sampidevkit/ACIM-Inverter/V0/Production/Pic/Top2.png

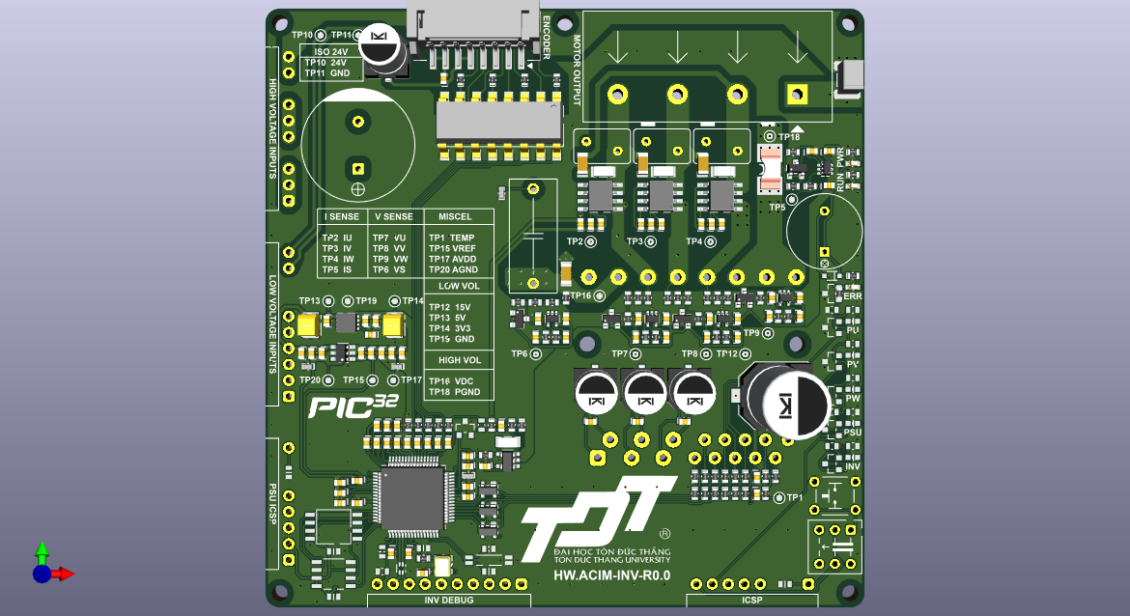
V0/Production/Pic/Top2.png
