sampidevkit/ACIM-Inverter/V0/Production/Pic/Top3.png

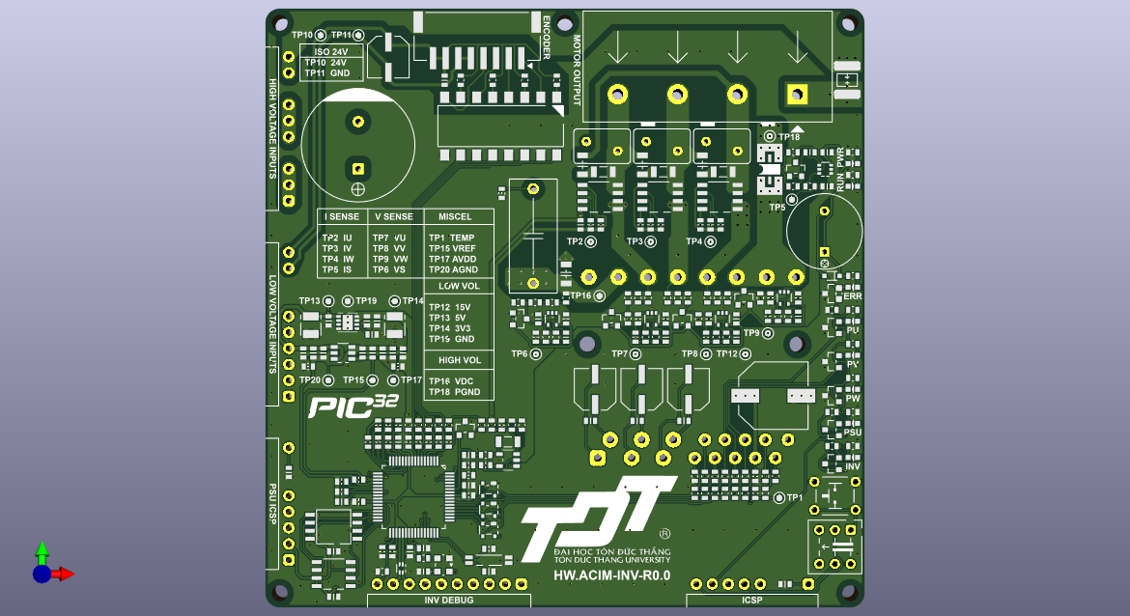
V0/Production/Pic/Top3.png
