sampidevkit/ACIM-Inverter/V0/Production/Pic/Bot.png

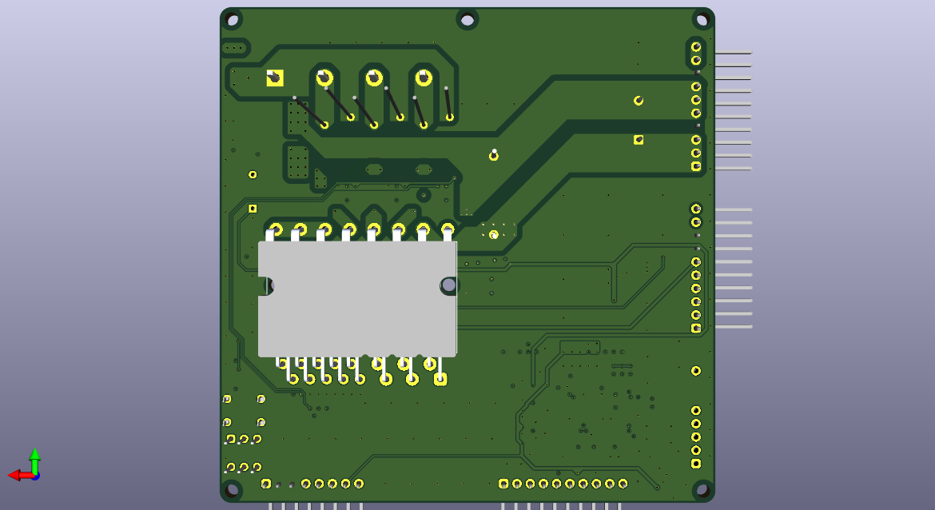
V0/Production/Pic/Bot.png
