sampidevkit/ACIM-Inverter/V0/Production/Pic/Top.png

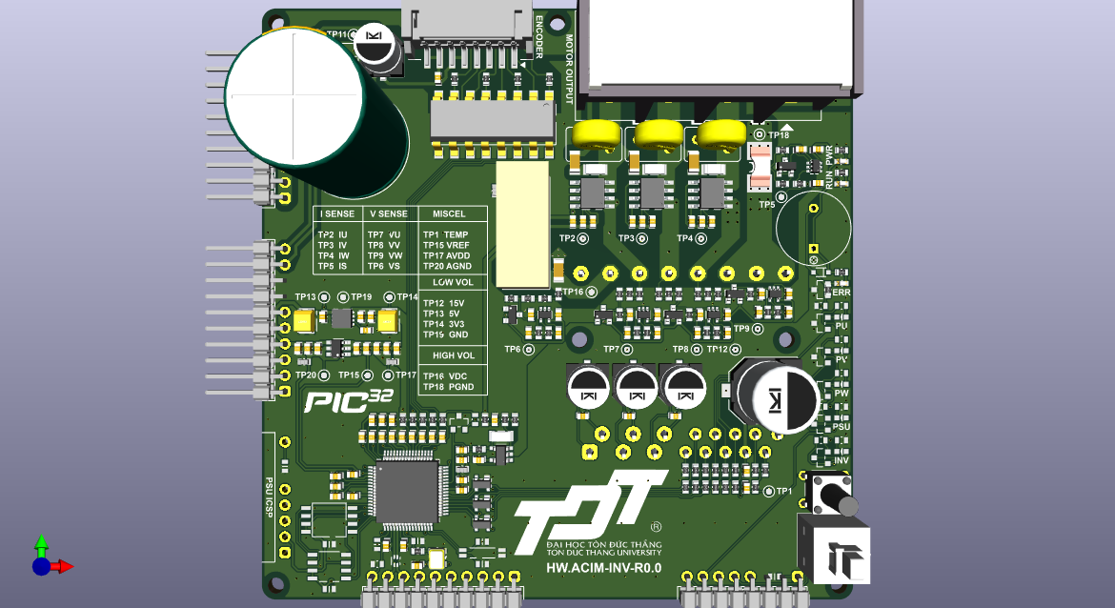
V0/Production/Pic/Top.png
