sampidevkit/ACIM-Inverter/V0/Production/BoM/HW.ACIM-INV.xlsx

# | MNP | MFT | Description | Reference | Qty | Unit Price | Sub-Price | Stock Link
1 | TS02-66-170-BK-160-SCR-D | CUI | SWITCH TACTILE 6x6x17MM SPST-NO 0.05A 12V | BT1 | 1 |  | 0
2 | AT-1224-TWT-5V-2-R | PUI | BUZZER MAGNETIC 5V 12MM TH | BZ1 | 1 |  | 0
3 | ECW-FE2W105K | Panasonic | CAP FILM 1UF 10% 450VDC RADIAL | C1 | 1 |  | 0
4 | CL10B104KB8NNNC | Samsung | CAP CER 0.1UF 50V X7R 0603 | C2,C5,C7,C9,C10,C17,C20,C22,C23,C24,C26,C27,C28,C31,C34,C35,C38,C39,C40,C41,C42,C50,C53,C61,C63,C66,C74,C78,C79,C89,C93,C94,C95,C96,C100 | 35 |  | 0
5 | A768EB476M1VLAE042 | KEMET | CAP ALUM POLY 47UF 20% 35V SMD | C3,C4,C6,C73 | 4 |  | 0
6 | CL10B102KB8NNNC | Samsung | CAP CER 1nF 50V X7R 0603 | C8,C15,C18,C19,C21,C25,C29,C30,C37,C62,C64,C65,C67,C68 | 14 |  | 0
7 | 885342208022 | WE | CAP CER 100PF 2000V X7R 1206 | C11,C12,C13,C14 | 4 |  | 0
8 | A768MS477M1ELAE017 | KEMET | CAP ALUM POLY 470UF 20% 25V SMD | C16 | 1 |  | 0
9 | TLJB227M006R0500 | KAVX | CAP TANT 220UF 20% 6.3V 1411 | C32,C83 | 2 |  | 0
10 | 0603N220J500CT | Walsin | CAP CER 22PF 50V C0G/NP0 0603 | C33,C36,C43,C44,C45,C46,C47,C49,C51,C52,C57,C58,C60,C69,C70,C71,C72,C90,C91,C97,C101 | 21 |  | 0
11 | CL10A106MQ8NNNC | Samsung | CAP CER 10UF 6.3V X5R 0603 | C48,C54,C55,C59,C92 | 5 |  | 0
12 | CL10B332KB8NNNC | Samsung | CAP CER 3.3nF 50V X7R 0603 | C56 | 1 |  | 0
13 | VW2W101MNN1825A4EF3 | Elite | CAP ALUM 100UF 20% 450V SNAP | C75 | 1 |  | 0
14 | CC0603BRNPO9BN9R0 | YAGEO | CAP CER 9PF 50V C0G/NPO 0603 | C98,C99 | 2 |  | 0
15 | MMBD4148SE | ANBON | DIODE ARRAY GP 75V 150MA SOT23 | D1,D2,D3,D4,D20 | 5 |  | 0
16 | B19Y1NB--20C000113U1930 | Harvatek | LED BLUE CLEAR 0603 SMD | D5,D14 | 2 |  | 0
17 | B1911USD-20D000114U1930 | Harvatek | LED RED DIFFUSED 0603 SMD | D6,D12 | 2 |  | 0
18 | 1N4148WX-TP | MCC | DIODE GEN PURP 75V 150MA SOD323 | D7 | 1 |  | 0
19 | B1911NG--20D000214U1930 | Harvatek | LED GREEN DIFFUSED 0603 SMD | D8 | 1 |  | 0
20 | B1931TW--20P000314U1930 | Harvatek | LED WHITE 0603 SMD | D9,D13 | 2 |  | 0
21 | PRTR5V0U2X,215 | Nexperia | TVS DIODE 5.5VWM SOT143B | D10,D11,D15 | 3 |  | 0
22 | PE-0603PFB121ST | Pulse | FERRITE BEAD 120 OHM 1A 0603 1LN | FT1,FT2,FT3,FT6 | 4 |  | 0
23 | MCM1012B121F06BPDG | INPAQ | CMF 1210 120OHM 300MA 2LN SMD | FT7 | 1 |  | 0
24 | 4532-301-LF | YAGEO | GDT SMD 4532, 300V30% 2KA, REEL | G1 | 1 |  | 0
25 | PPTC101LGBN-RC | Sullins | CONN HDR 10POS 0.1 TIN PCB R/A | J1,J4,J6 | 3 |  | 0
26 | PBC08SBAN | Sullins | CONN HEADER R/A 8POS 2.54MM | J2 | 1 |  | 0
27 | YK4410403000G | Amphenol | CONN BARRIER STRIP 4CIRC 0.374" | J3 | 1 |  | 0
28 | PPTC081LGBN-RC | Sullins | CONN HDR 8POS 0.1 TIN PCB R/A | J5 | 1 |  | 0
29 | CI0108M1HR0-NH | Cvilux | 8 POS 2.00MM(.079) SINGLE ROW SM | J8 | 1 |  | 0
30 | 561KD07 | YAGEO | VARISTOR 560V 1.75KA DISC 7MM | M1,M2,M3 | 3 |  | 0
31 | TLP293-4(TP,E | Toshiba | OPTOISOLATOR 3.75KV TRANS SO16 | OP1 | 1 |  | 0
32 | DMN2310U-7 | Diodes | MOSFET N-CH 20 V 1.6A SOT-23-3 | Q1,Q3,Q4,Q5,Q6 | 5 |  | 0
33 | SI2301CDS-T1-GE3 | Vishay | MOSFET P-CH 20V 3.1A SOT23-3 | Q2 | 1 |  | 0
34 | RC0603FR-07100KL | YAGEO | RES 100K OHM 1% 1/10W 0603 | R1,R2,R4,R8,R9,R12,R16,R17,R18,R23,R24,R25,R26,R28,R34,R35,R37,R48,R49,R51,R56,R58,R110 | 23 |  | 0
35 | AC0603FR-071K1L | YAGEO | RES SMD 1.1K OHM 1% 1/10W 0603 | R3,R6,R10,R11,R13,R14,R15,R19,R20,R21,R22,R29,R33,R36,R39,R50,R53,R55,R57,R59,R60,R62,R64,R66,R70,R71,R72 | 27 |  | 0
36 | RC0603FR-0710RL | YAGEO | RES 10 OHM 1% 1/10W 0603 | R5,R27,R32,R38,R40,R41,R42,R52 | 8 |  | 0
37 | RC0603JR-070RL | YAGEO | RES 0 OHM JUMPER 1/10W 0603 | R7,R111 | 2 |  | 0
38 | WR12X105 JTL | Walsin | RES 1M OHM 5% 1/4W 1206 | R30 | 1 |  | 0
39 | RC0603FR-13470KL | YAGEO | RES 470K OHM 1% 1/10W 0603 | R31 | 1 |  | 0
40 | MSMA2512R0050FGM | Eaton | RES 0.005 OHM 1% 3W 2512 | R43 | 1 |  | 0
41 | AC0603FR-074K3L | YAGEO | RES SMD 4.3K OHM 1% 1/10W 0603 | R44,R45,R46,R61 | 4 |  | 0
42 | RC0603FR-0710KL | YAGEO | RES 10K OHM 1% 1/10W 0603 | R47,R54 | 2 |  | 0
43 | RNCP1206FTD4R70 | Stackpole | RES 4.7 OHM 1% 1/2W 1206 | R63,R68,R69 | 3 |  | 0
44 | TL2201EEYA | E-Switch | SWITCH PUSH DPDT 0.1A 30V | SW1 | 1 |  | 0
45 | IKCM15H60GAXKMA2 | Infineon | IFPS MODULES 24MDIP | U1 | 1 |  | 0
46 | NCV21871SQ3T2G | Onsemi | IC OPAMP GP 1 CIRCUIT SC88A | U2,U12,U15,U16 | 4 |  | 0
47 | ZXCT199QA1DW-7 | Diodes | CM VOLTAGE OUTPUT SOT363 T&R 3K | U3 | 1 |  | 0
48 | AP331AWG-7 | Diodes | IC COMPARATOR 1 GEN PUR SOT25 | U4 | 1 |  | 0
49 | PIC32MK1024MCM064-I/PT | Microchip | IC MCU 32BIT 1MB FLASH 64TQFP | U5 | 1 |  | 0
50 | DSC1001CE1-012.0000 | Microchip | MEMS OSC XO 12.0000MHZ CMOS SMD | U6 | 1 |  | 0
51 | ACS724LLCTR-10AB-T | Allegro | SENSOR CURRENT HALL 10A AC/DC | U7,U9,U10 | 3 |  | 0
52 | MCP1501T-33E/CHY | Microchip | IC VREF SERIES 0.1% SOT23-6 | U8 | 1 |  | 0
53 | M95256-WMN6P | ST | IC EEPROM 256KBIT SPI 8SOIC | U11 | 1 |  | 0
54 | W25Q128FVSG | Winbond | IC FLASH 128MBIT SPI/QUAD 8SOIC | U13 | 1 |  | 0
55 | MCP1727-3302E/MF | Microchip | IC REG LINEAR 3.3V 1.5A 8DFN | U14 | 1 |  | 0
56 | 32.768K12.5PI/6914E | YIC | CRYSTAL 32.7680KHZ 12.5PF SMD | X1 | 1 |  | 0
 |  |  |  |  |  |  | 0
