sampidevkit/ACIM-Inverter/V0/Production/Sch/HW.ACIM-INV.pdf

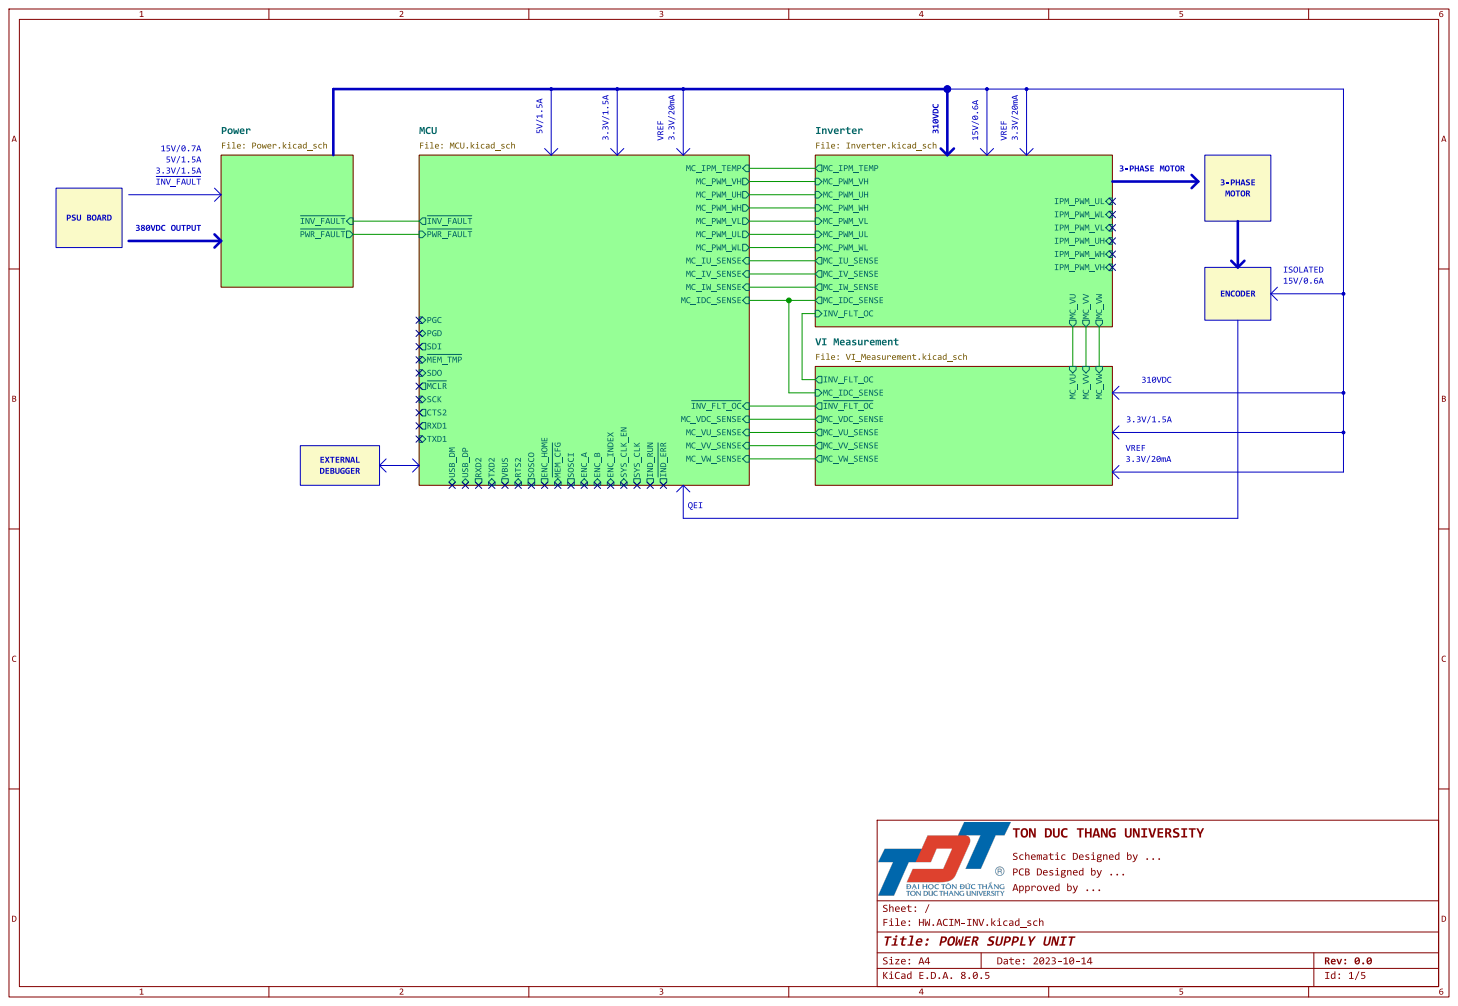
[picture p5: page 1]

Schematic Designed by ... PCB Designed by ... Approved by ...

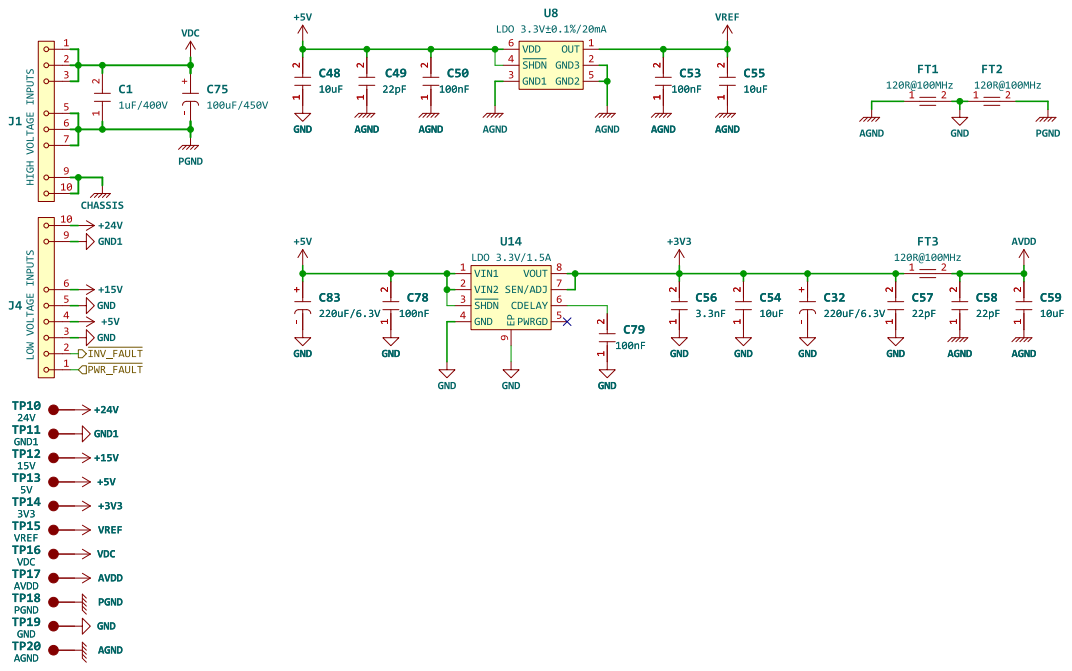
[picture p6: page 2]

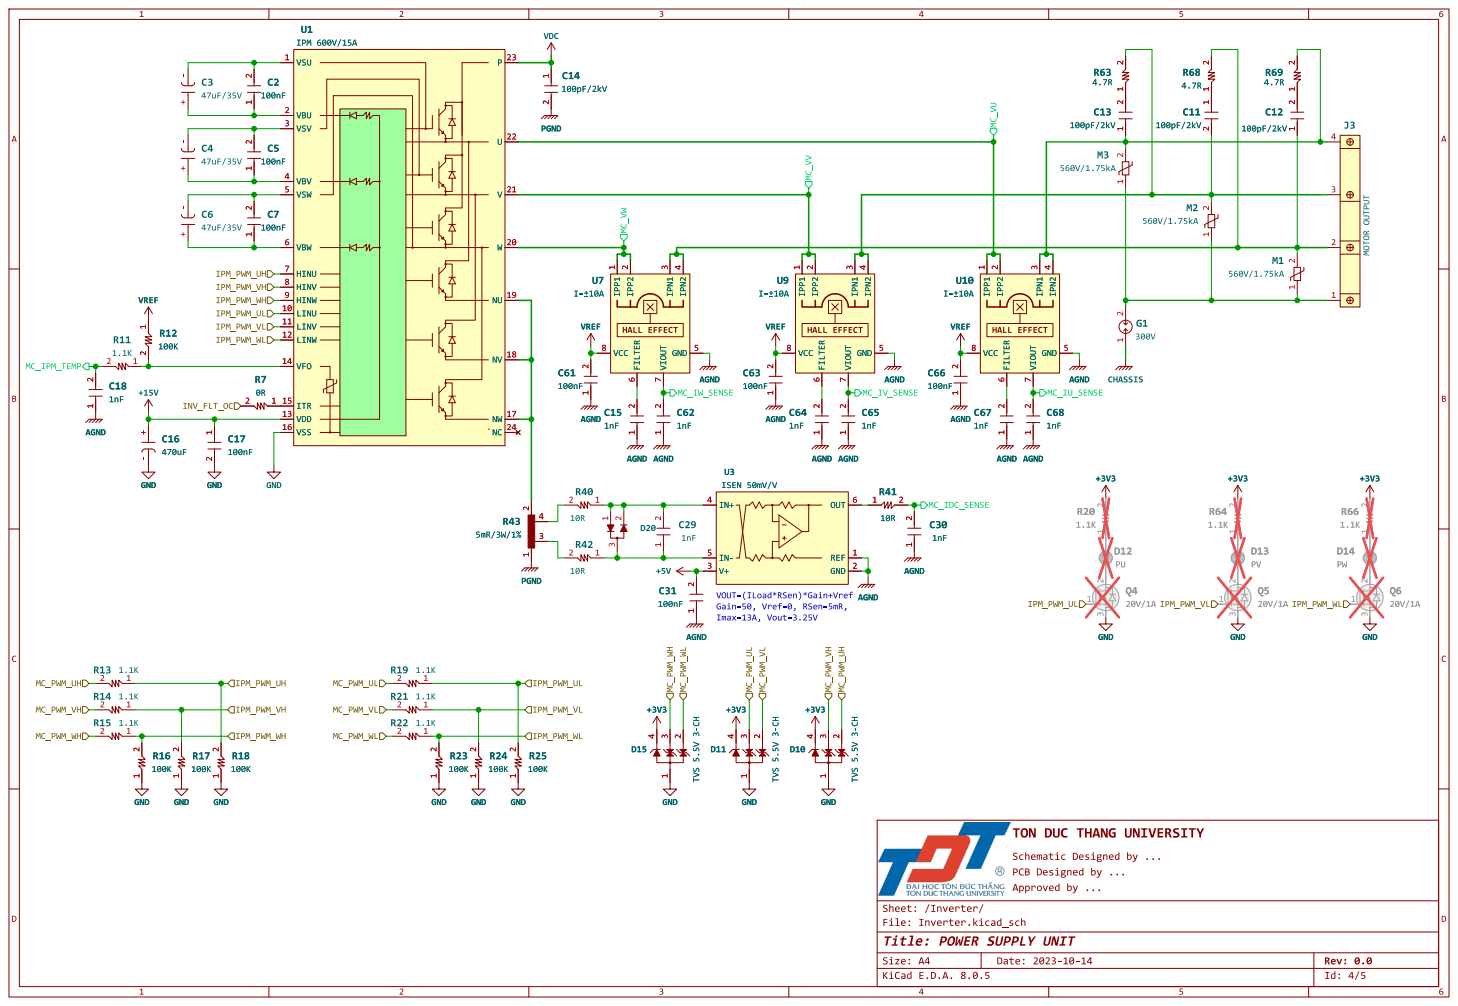
[picture p7: page 3]

Schematic Designed by ... PCB Designed by ... Approved by ...

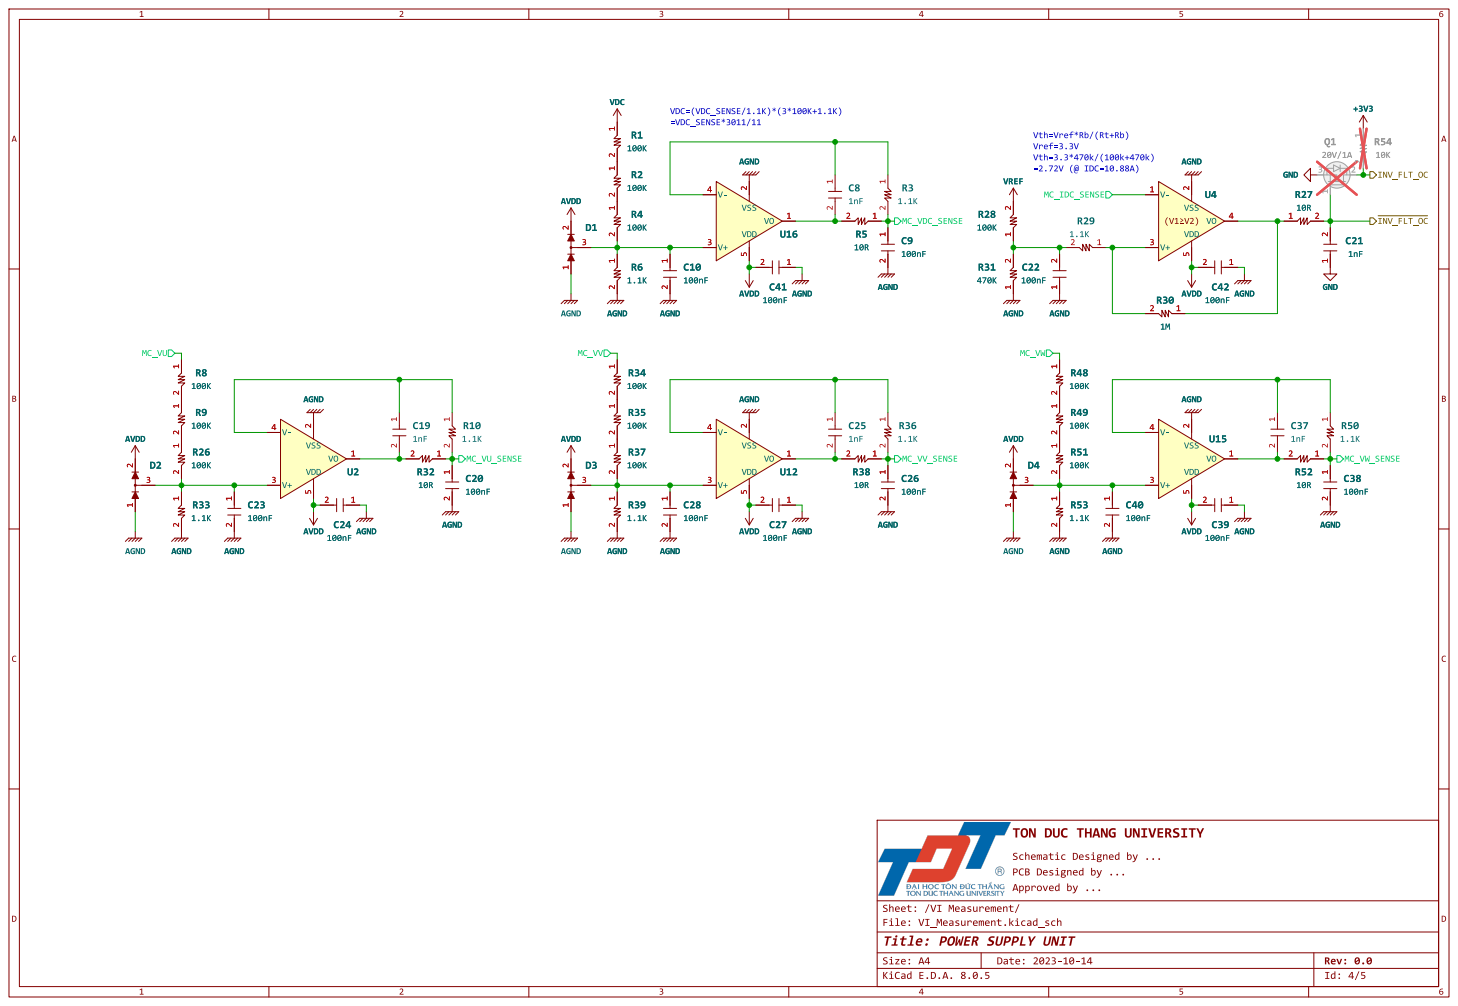
[picture p8: page 4]

Schematic Designed by ... PCB Designed by ... Approved by ...

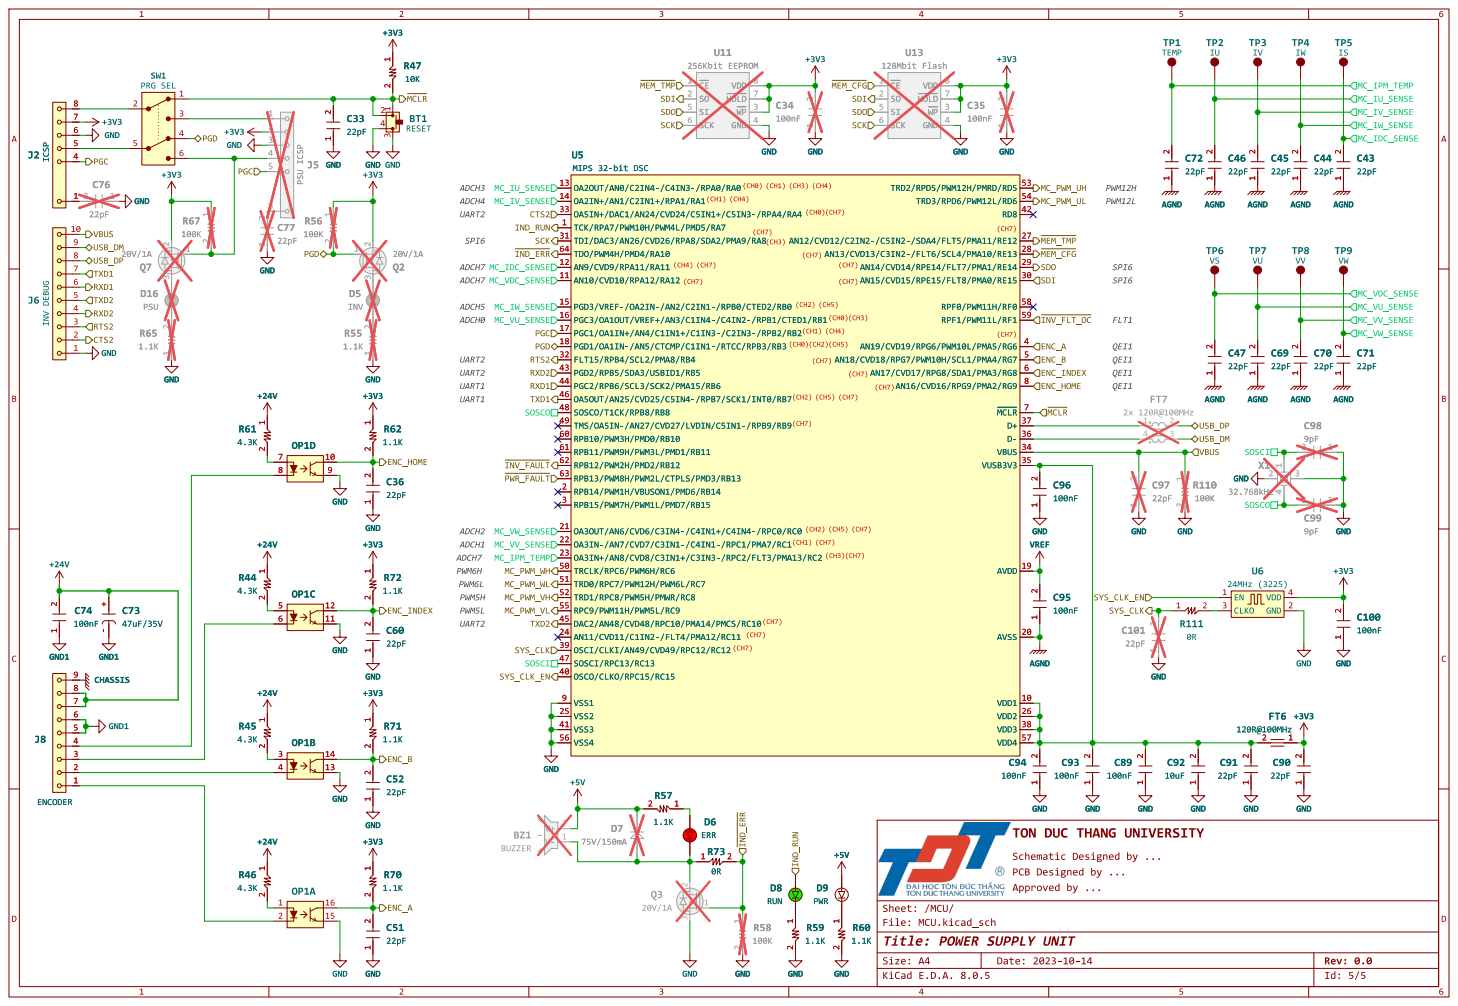
[picture p9: page 5]

1 2 GND
Schematic Designed by ... PCB Designed by ... Approved by ... 1 2 R46
