sampidevkit/ACIM-Inverter/V0/Design/HW.ACIM-INV/Inverter.kicad_sch

## KiCad design V0/Design/HW.ACIM-INV/Inverter.kicad_sch (2024-09-25)

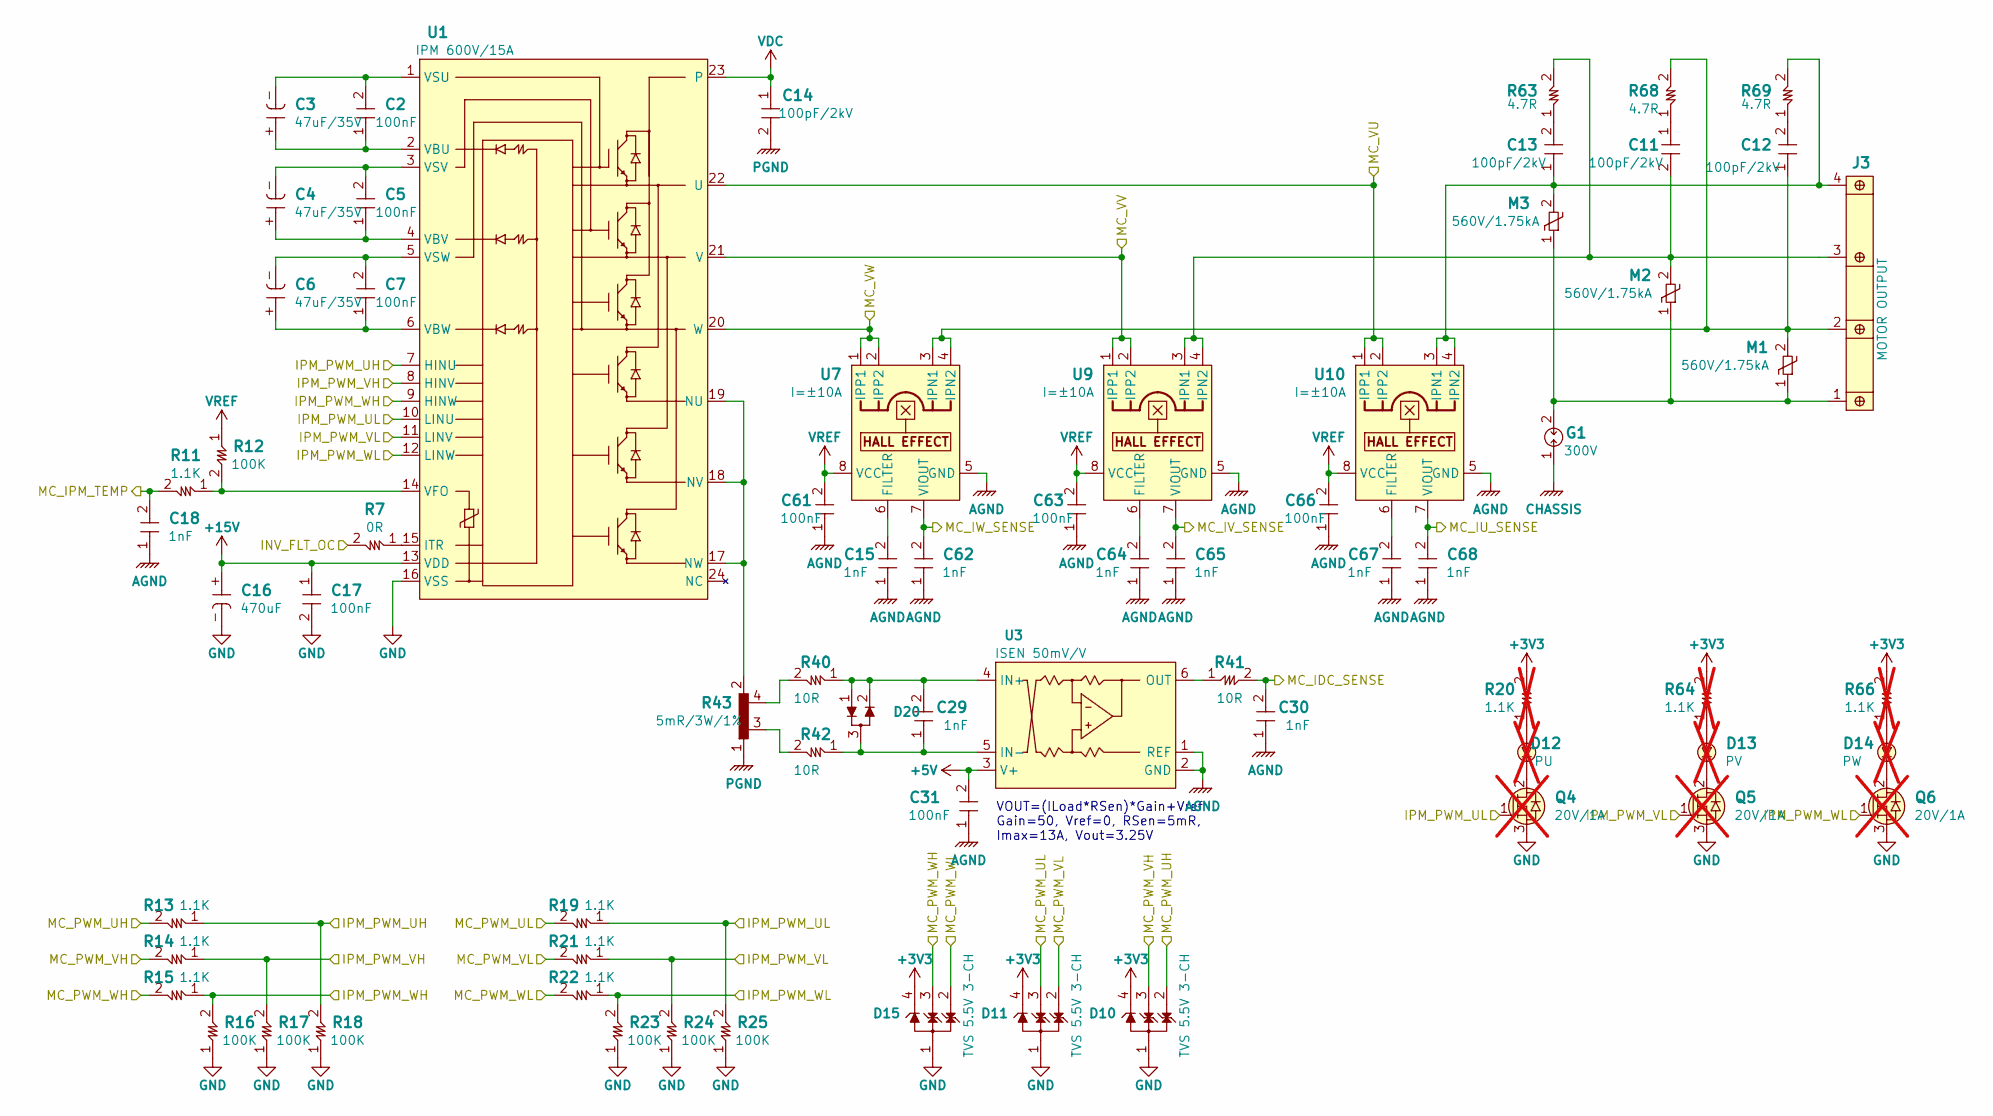
[picture p10: schematic Inverter.kicad_sch]

Parts:
C2, C5, C7, C17, C31, C61, C63, C66: 100nF; CAP0603
C3, C4, C6: 47uF/35V; CAP_ELEC-6.6x6.6-DIA6.3
C11, C12, C13, C14: 100pF/2kV; CAP1206
C15, C18, C29, C30, C62, C64, C65, C67, C68: 1nF; CAP0603
C16: 470uF; CAP_ELEC-10.3x10.3-DIA10
D10, D11, D15: TVS 5.5V 3-CH; SOT143B_NEXT
D12: PU; LED0603; not fitted
D13: PV; LED0603; not fitted
D14: PW; LED0603; not fitted
D20: GP DIODE; SOT23
G1: 300V; GDT1812_3532
J3: MOTOR OUTPUT; TMB4_9.5
M1, M2, M3: 560V/1.75kA; MOV5MM
Q4, Q5, Q6: 20V/1A; SOT23; not fitted
R7: 0R; RES0603
R11, R13, R14, R15, R19, R21, R22: 1.1K; RES0603
R12, R16, R17, R18, R23, R24, R25: 100K; RES0603
R20, R64, R66: 1.1K; RES0603; not fitted
R40, R41, R42: 10R; RES0603
R43: 5mR/3W/1%; SHU2512
R63, R68, R69: 4.7R; RES1206
U1: IPM 600V/15A; CIPOS-MINI
U3: ISEN 50mV/V; SOT363
U7, U9, U10: I=±10A; SOIC8_ALL

Connections:
+3V3: D10.4 (CH3), D11.4 (CH3), D15.4 (CH3), R20.2, R64.2, R66.2
+5V: C31.2, U3.3 (V+)
+15V: C16.+, C17.1, U1.13 (VDD)
AGND: C15.1, C18.1, C30.1, C31.1, C61.1, C62.1, C63.1, C64.1, C65.1, C66.1, C67.1, C68.1, U3.1 (REF), U3.2 (GND), U7.5 (GND), U9.5 (GND), U10.5 (GND)
CHASSIS: G1.1
GND: C16.-, C17.2, D10.1 (GND), D11.1 (GND), D15.1 (GND), Q4.3 (S), Q5.3 (S), Q6.3 (S), R16.1, R17.1, R18.1, R23.1, R24.1, R25.1, U1.16 (VSS)
INV_FLT_OC: R7.2
IPM_PWM_UH: R13.1, R18.2, U1.7 (HINU)
IPM_PWM_UL: Q4.1 (G), R19.1, R25.2, U1.10 (LINU)
IPM_PWM_VH: R14.1, R17.2, U1.8 (HINV)
IPM_PWM_VL: Q5.1 (G), R21.1, R24.2, U1.11 (LINV)
IPM_PWM_WH: R15.1, R16.2, U1.9 (HINW)
IPM_PWM_WL: Q6.1 (G), R22.1, R23.2, U1.12 (LINW)
MC_IDC_SENSE: C30.2, R41.2
MC_IPM_TEMP: C18.2, R11.2
MC_IU_SENSE: C68.2, U10.7 (VIOUT)
MC_IV_SENSE: C65.2, U9.7 (VIOUT)
MC_IW_SENSE: C62.2, U7.7 (VIOUT)
MC_PWM_UH: D10.2 (CH1), R13.2
MC_PWM_UL: D11.3 (CH2), R19.2
MC_PWM_VH: D10.3 (CH2), R14.2
MC_PWM_VL: D11.2 (CH1), R21.2
MC_PWM_WH: D15.3 (CH2), R15.2
MC_PWM_WL: D15.2 (CH1), R22.2
MC_VU: U1.22 (U), U10.1 (IPP1), U10.2 (IPP2)
MC_VV: U1.21 (V), U9.1 (IPP1), U9.2 (IPP2)
MC_VW: U1.20 (W), U7.1 (IPP1), U7.2 (IPP2)
unnamed: C2.1, C3.+, U1.2 (VBU)
unnamed: C2.2, C3.-, U1.1 (VSU)
unnamed: C4.+, C5.1, U1.4 (VBV)
unnamed: C4.-, C5.2, U1.3 (VSV)
unnamed: C6.+, C7.1, U1.6 (VBW)
unnamed: C6.-, C7.2, U1.5 (VSW)
unnamed: C11.1, R68.1
unnamed: C11.2, J3.3, M2.2, R63.2, U9.3 (IPN1), U9.4 (IPN2)
unnamed: C12.1, J3.2, M1.2, R68.2, U7.3 (IPN1), U7.4 (IPN2)
unnamed: C12.2, R69.1
unnamed: C13.1, J3.4, M3.2, R69.2, U10.3 (IPN1), U10.4 (IPN2)
unnamed: C13.2, R63.1
unnamed: C15.2, U7.6 (FILTER)
unnamed: C29.1, D20.3 (COM), R42.1, U3.5 (IN-)
unnamed: C29.2, D20.1 (K1), D20.2 (K2), R40.1, U3.4 (IN+)
unnamed: C64.2, U9.6 (FILTER)
unnamed: C67.2, U10.6 (FILTER)
unnamed: D12.A, R20.1
unnamed: D12.K, Q4.2 (D)
unnamed: D13.A, R64.1
unnamed: D13.K, Q5.2 (D)
unnamed: D14.A, R66.1
unnamed: D14.K, Q6.2 (D)
unnamed: G1.2, J3.1, M1.1, M2.1, M3.1
unnamed: R7.1, U1.15 (ITR)
unnamed: R11.1, R12.2, U1.14 (VFO)
unnamed: R40.2, R43.4
unnamed: R41.1, U3.6 (OUT)
unnamed: R42.2, R43.3
unnamed: R43.2, U1.17 (NW), U1.18 (NV), U1.19 (NU)
PGND: C14.2, R43.1
VDC: C14.1, U1.23
VREF: C61.2, C63.2, C66.2, R12.1, U7.8 (VCC), U9.8 (VCC), U10.8 (VCC)

Notes on the sheet:
VOUT=(ILoad*RSen)*Gain+Vref Gain=50, Vref=0, RSen=5mR, Imax=13A, Vout=3.25V
