sampidevkit/ACIM-Inverter/V0/Design/HW.ACIM-INV/MCU.kicad_sch

## KiCad design V0/Design/HW.ACIM-INV/MCU.kicad_sch (2024-10-11)

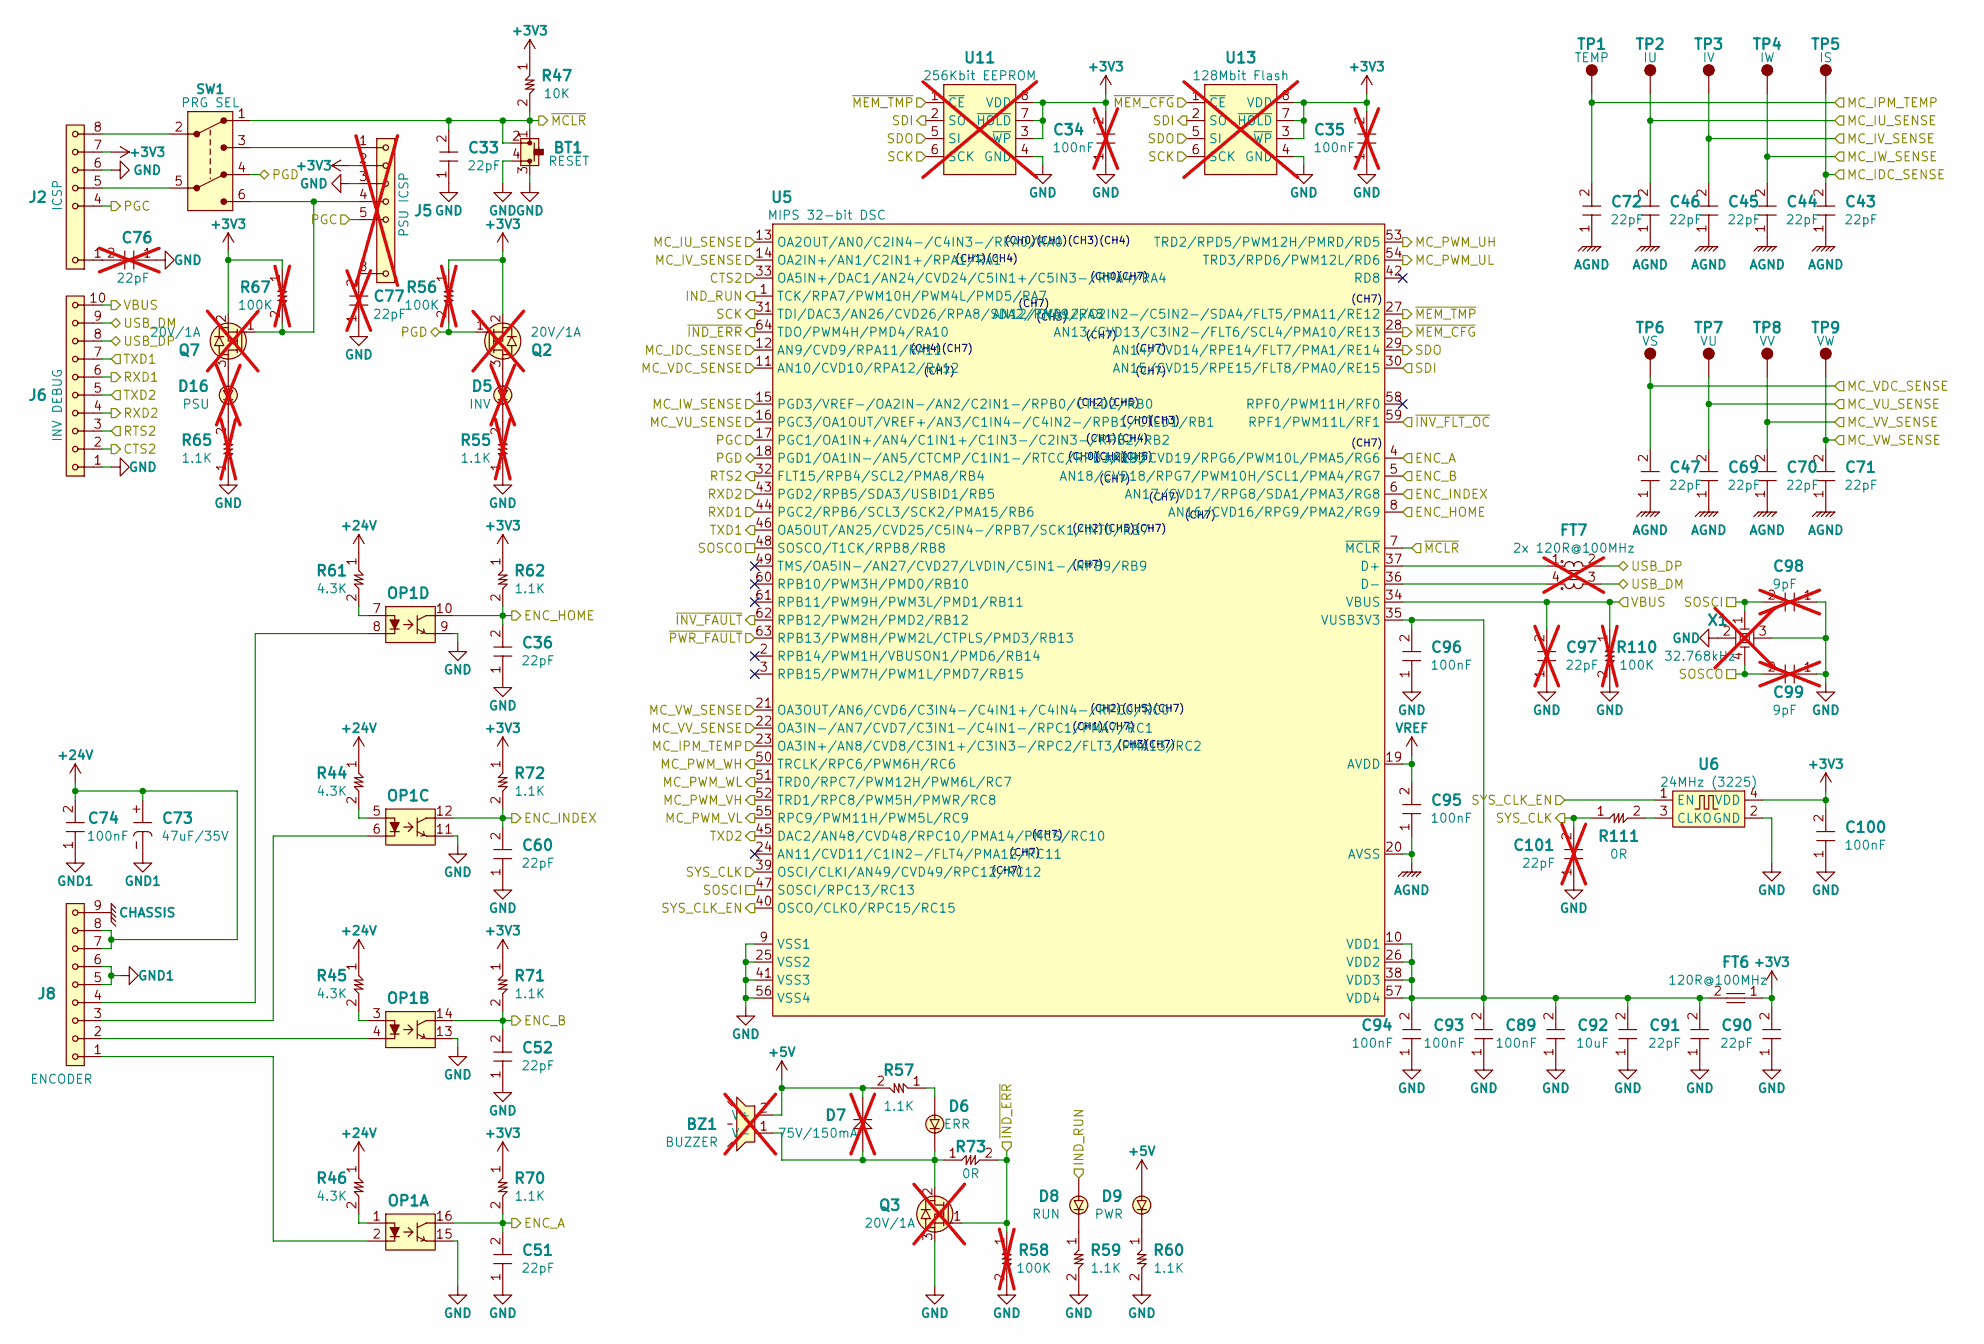
[picture p11: schematic MCU.kicad_sch]

Parts:
BT1: RESET; BUTTON_4P_6x6
BZ1: BUZZER; AT-1224; not fitted
C33, C36, C43, C44, C45, C46, C47, C51, C52, C60, C69, C70, C71, C72, C90, C91: 22pF; CAP0603
C34, C35: 100nF; CAP0603; not fitted
C73: 47uF/35V; CAP_ELEC-6.6x6.6-DIA6.3
C74, C89, C93, C94, C95, C96, C100: 100nF; CAP0603
C76, C77, C97, C101: 22pF; CAP0603; not fitted
C92: 10uF; CAP0603
C98, C99: 9pF; CAP0603; not fitted
D5: INV; LED0603; not fitted
D6: ERR; LED0603
D7: 75V/150mA; SOD-323; not fitted
D8: RUN; LED0603
D9: PWR; LED0603
D16: PSU; LED0603; not fitted
FT6: 120R@100MHz; FT0603
FT7: 2x 120R@100MHz; IND1210_4P; not fitted
J2: ICSP; HDM1x8x2.54_TH_RA
J5: PSU ICSP; HDF1x8x2.54_TH_RA; not fitted
J6: INV DEBUG; HDM1x10x2.54_TH_RA
J8: ENCODER; HDM1x8x2.0_SMA_RA
OP1: OPTO-BJT-4CH; OPTO_SO16_6.5MM
Q2, Q3, Q7: 20V/1A; SOT23; not fitted
R44, R45, R46, R61: 4.3K; RES0603
R47: 10K; RES0603
R55, R65: 1.1K; RES0603; not fitted
R56, R58, R67, R110: 100K; RES0603; not fitted
R57, R59, R60, R62, R70, R71, R72: 1.1K; RES0603
R73, R111: 0R; RES0603
SW1: PRG SEL; SW_PUSH_2DPDT
TP1: TEMP; TP1MM
TP2: IU; TP1MM
TP3: IV; TP1MM
TP4: IW; TP1MM
TP5: IS; TP1MM
TP6: VS; TP1MM
TP7: VU; TP1MM
TP8: VV; TP1MM
TP9: VW; TP1MM
U5: MIPS 32-bit DSC; TQFP64_10x10_MCHP
U6: 24MHz (3225); CDFN3225-4LD-PL-1
U11: 256Kbit EEPROM; SOIC8_3.9_MCHP; not fitted
U13: 128Mbit Flash; SO8W_5.3; not fitted
X1: 32.768kHz; SMD4-7015; not fitted

Connections:
+3V3: C34.2, C35.2, C90.2, C100.2, FT6.1, J2.7, J5.2, Q2.2 (S), Q7.2 (S), R47.1, R56.1, R62.1, R67.1, R70.1, R71.1, R72.1, U6.4 (VDD), U11.3 (~WP), U11.7 (~HOLD), U11.8 (VDD), U13.3 (~WP), U13.7 (~HOLD), U13.8 (VDD)
+5V: BZ1.2 (V+), D7.K, D9.A, R57.2
+24V: C73.+, C74.2, J8.7, J8.8, R44.1, R45.1, R46.1, R61.1
AGND: C43.1, C44.1, C45.1, C46.1, C47.1, C69.1, C70.1, C71.1, C72.1, C95.1, U5.20 (AVSS)
CHASSIS: J8.9
CTS2: J6.2, U5.33 (OA5IN+/DAC1/AN24/CVD24/C5IN1+/C5IN3-/RP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)
ENC_A: C51.2, OP1.16 (C1), R70.2, U5.4 (AN19/CVD19/RPG6/PWM10L/PMA5/RG6)
ENC_B: C52.2, OP1.14 (C2), R71.2, U5.5 (AN18/CVD18/RPG7/PWM10H/SCL1/PMA4/RG7)
ENC_HOME: C36.2, OP1.10 (C4), R62.2, U5.8 (AN16/CVD16/RPG9/PMA2/RG9)
ENC_INDEX: C60.2, OP1.12 (C3), R72.2, U5.6 (AN17/CVD17/RPG8/SDA1/PMA3/RG8)
GND: BT1.3, BT1.4, C33.1, C34.1, C35.1, C36.1, C51.1, C52.1, C60.1, C76.1, C77.1, C89.1, C90.1, C91.1, C92.1, C93.1, C94.1, C96.1, C97.1, C98.1, C99.1, C100.1, C101.1, J2.6, J5.3, J6.1, OP1.9 (E4), OP1.11 (E3), OP1.13 (E2), OP1.15 (E1), Q3.3 (S), R55.1, R58.2, R59.2, R60.2, R65.1, R110.2, U5.9 (VSS1), U5.25 (VSS2), U5.41 (VSS3), U5.56 (VSS4), U6.2 (GND), U11.4 (GND), U13.4 (GND), X1.2 (GND1), X1.3 (X2)
GND1: C73.-, C74.1, J8.5, J8.6
IND_RUN: D8.A, U5.1 (TCK/RPA7/PWM10H/PWM4L/PMD5/RA7)
MC_IDC_SENSE: C43.2, TP5.1, U5.12 (AN9/CVD9/RPA11/RA11)
MC_IPM_TEMP: C72.2, TP1.1, U5.23 (OA3IN+/AN8/CVD8/C3IN1+/C3IN3-/RPC2/FLT3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)
MC_IU_SENSE: C46.2, TP2.1, U5.13 (OA2OUT/AN0/C2IN4-/C4IN3-/RPA0/RA0)
MC_IV_SENSE: C45.2, TP3.1, U5.14 (OA2IN+/AN1/C2IN1+/RPA1/RA1)
MC_IW_SENSE: C44.2, TP4.1, U5.15 (PGD3/VREF-/OA2IN-/AN2/C2IN1-/RPB0/CTED2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)
MC_PWM_UH: U5.53 (TRD2/RPD5/PWM12H/PMRD/RD5)
MC_PWM_UL: U5.54 (TRD3/RPD6/PWM12L/RD6)
MC_PWM_VH: U5.52 (TRD1/RPC8/PWM5H/PMWR/RC8)
MC_PWM_VL: U5.55 (RPC9/PWM11H/PWM5L/RC9)
MC_PWM_WH: U5.50 (TRCLK/RPC6/PWM6H/RC6)
MC_PWM_WL: U5.51 (TRD0/RPC7/PWM12H/PWM6L/RC7)
MC_VDC_SENSE: C47.2, TP6.1, U5.11 (AN10/CVD10/RPA12/RA12)
MC_VU_SENSE: C69.2, TP7.1, U5.16 (PGC3/OA1OUT/VREF+/AN3/C1IN4-/C4IN2-/RPB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)
MC_VV_SENSE: C70.2, TP8.1, U5.22 (OA3IN-/AN7/CVD7/C3IN1-/C4IN1-/RPC1/PMA7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)
MC_VW_SENSE: C71.2, TP9.1, U5.21 (OA3OUT/AN6/CVD6/C3IN4-/C4IN1+/C4IN4-/RP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)
unnamed: BZ1.1 (V-), D6.K, D7.A, Q3.2 (D), R73.1
unnamed: C76.2, J2.1
unnamed: C77.2, J5.8
unnamed: C89.2, C91.2, C92.2, C93.2, C94.2, C96.2, FT6.2, U5.10 (VDD1), U5.26 (VDD2), U5.35 (VUSB3V3), U5.38 (VDD3), U5.57 (VDD4)
unnamed: D5.A, Q2.3 (D)
unnamed: D5.K, R55.2
unnamed: D6.A, R57.1
unnamed: D8.K, R59.1
unnamed: D9.K, R60.1
unnamed: D16.A, Q7.3 (D)
unnamed: D16.K, R65.2
unnamed: FT7.1, U5.37 (D+)
unnamed: FT7.4, U5.36 (D-)
unnamed: J2.5, SW1.5 (COM2)
unnamed: J2.8, SW1.2 (COM1)
unnamed: J5.1, SW1.3 (NO1)
unnamed: J5.4, Q7.1 (G), R67.2, SW1.6 (NO2)
unnamed: J8.1, OP1.2 (K1)
unnamed: J8.2, OP1.4 (K2)
unnamed: J8.3, OP1.6 (K3)
unnamed: J8.4, OP1.8 (K4)
unnamed: OP1.1 (A1), R46.2
unnamed: OP1.3 (A2), R45.2
unnamed: OP1.5 (A3), R44.2
unnamed: OP1.7 (A4), R61.2
unnamed: R111.2, U6.3 (CLKO)
PGC: J2.4, J5.5, U5.17 (PGC1/OA1IN+/AN4/C1IN1+/C1IN3-/C2IN3-/RP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)
PGD: Q2.1 (G), R56.2, SW1.4 (NC2), U5.18 (PGD1/OA1IN-/AN5/CTCMP/C1IN1-/RTCC/RPB3/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)
RTS2: J6.3, U5.32 (FLT15/RPB4/SCL2/PMA8/RB4)
RXD1: J6.6, U5.44 (PGC2/RPB6/SCL3/SCK2/PMA15/RB6)
RXD2: J6.4, U5.43 (PGD2/RPB5/SDA3/USBID1/RB5)
SCK: U5.31 (TDI/DAC3/AN26/CVD26/RPA8/SDA2/PMA9/RA8), U11.6 (SCK), U13.6 (SCK)
SDI: U5.30 (AN15/CVD15/RPE15/FLT8/PMA0/RE15), U11.2 (SO), U13.2 (SO)
SDO: U5.29 (AN14/CVD14/RPE14/FLT7/PMA1/RE14), U11.5 (SI), U13.5 (SI)
SOSCI: C98.2, U5.47 (SOSCI/RPC13/RC13), X1.1 (X1)
SOSCO: C99.2, U5.48 (SOSCO/T1CK/RPB8/RB8), X1.4 (GND2)
SYS_CLK: C101.2, R111.1, U5.39 (OSCI/CLKI/AN49/CVD49/RPC12/RC12)
SYS_CLK_EN: U5.40 (OSCO/CLKO/RPC15/RC15), U6.1 (EN)
TXD1: J6.7, U5.46 (OA5OUT/AN25/CVD25/C5IN4-/RPB7/SCK1/INT0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)
TXD2: J6.5, U5.45 (DAC2/AN48/CVD48/RPC10/PMA14/PMCS/RC10)
USB_DM: FT7.3, J6.9
USB_DP: FT7.2, J6.8
VBUS: C97.2, J6.10, R110.1, U5.34 (VBUS)
VREF: C95.2, U5.19 (AVDD)
~IND_ERR: Q3.1 (G), R58.1, R73.2, U5.64 (TDO/PWM4H/PMD4/RA10)
~INV_FAULT: U5.62 (RPB12/PWM2H/PMD2/RB12)
~INV_FLT_OC: U5.59 (RPF1/PWM11L/RF1)
~MCLR: BT1.1, BT1.2, C33.2, R47.2, SW1.1 (NC1), U5.7 (~MCLR)
~MEM_CFG: U5.28 (AN13/CVD13/C3IN2-/FLT6/SCL4/PMA10/RE13), U13.1 (~CE)
~MEM_TMP: U5.27 (AN12/CVD12/C2IN2-/C5IN2-/SDA4/FLT5/PMA1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), U11.1 (~CE)
~PWR_FAULT: U5.63 (RPB13/PWM8H/PWM2L/CTPLS/PMD3/RB13)

Notes on the sheet:
(CH0)
(CH7)
(CH5)
(CH2)
(CH4)
(CH1)
(CH3)
