sampidevkit/ACIM-Inverter/V0/Design/HW.ACIM-INV/Power.kicad_sch

## KiCad design V0/Design/HW.ACIM-INV/Power.kicad_sch (2024-09-25)

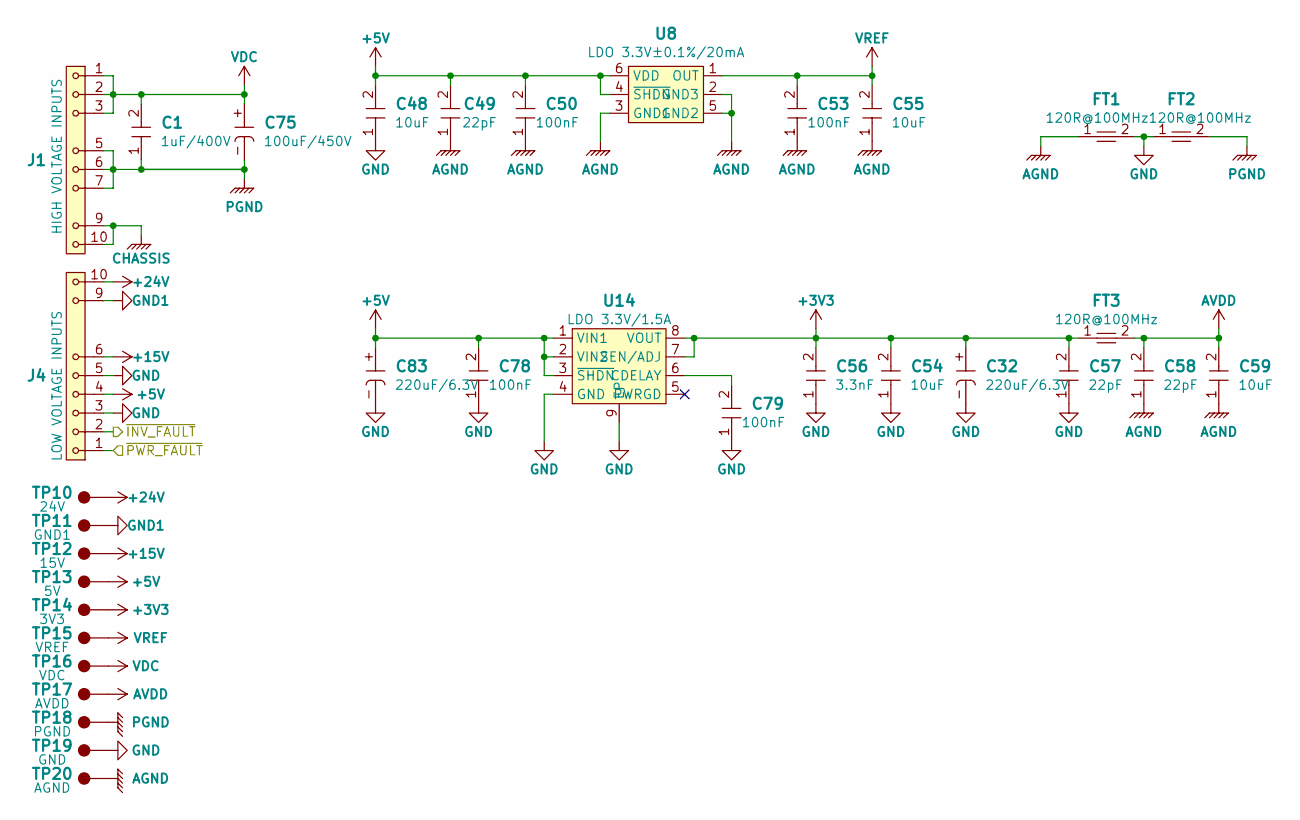
[picture p12: schematic Power.kicad_sch]

Parts:
C1: 1uF/400V; ECWFE2W105
C32, C83: 220uF/6.3V; CAP1411
C48, C54, C55, C59: 10uF; CAP0603
C49, C57, C58: 22pF; CAP0603
C50, C53, C78, C79: 100nF; CAP0603
C56: 3.3nF; CAP0603
C75: 100uF/450V; CAP_ELEC-18.0x51.5-LS7.5
FT1, FT2, FT3: 120R@100MHz; FT0603
J1: HIGH VOLTAGE INPUTS; HDM1x10x2.54_TH_RA
J4: LOW VOLTAGE INPUTS; HDM1x10x2.54_TH_RA
TP10: 24V; TP1MM
TP11: GND1; TP1MM
TP12: 15V; TP1MM
TP13: 5V; TP1MM
TP14: 3V3; TP1MM
TP15: VREF; TP1MM
TP16: VDC; TP1MM
TP17: AVDD; TP1MM
TP18: PGND; TP1MM
TP19: GND; TP1MM
TP20: AGND; TP1MM
U8: LDO 3.3V±0.1%/20mA; SOT-23-6_MCHP
U14: LDO 3.3V/1.5A; DFN8_3x3_MCHP

Connections:
+3V3: C32.+, C54.2, C56.2, C57.2, FT3.1, TP14.1, U14.7 (SEN/ADJ), U14.8 (VOUT)
+5V: C48.2, C49.2, C50.2, C78.2, C83.+, J4.4, TP13.1, U8.4 (~SHDN), U8.6 (VDD), U14.1 (VIN1), U14.2 (VIN2), U14.3 (~SHDN)
+15V: J4.6, TP12.1
+24V: J4.10, TP10.1
AGND: C49.1, C50.1, C53.1, C55.1, C58.1, C59.1, FT1.1, TP20.1, U8.2 (GND3), U8.3 (GND1), U8.5 (GND2)
AVDD: C58.2, C59.2, FT3.2, TP17.1
CHASSIS: J1.9, J1.10
GND: C32.-, C48.1, C54.1, C56.1, C57.1, C78.1, C79.1, C83.-, FT1.2, FT2.1, J4.3, J4.5, TP19.1, U14.4 (GND), U14.9 (EP)
GND1: J4.9, TP11.1
unnamed: C79.2, U14.6 (CDELAY)
PGND: C1.1, C75.-, FT2.2, J1.5, J1.6, J1.7, TP18.1
VDC: C1.2, C75.+, J1.1, J1.2, J1.3, TP16.1
VREF: C53.2, C55.2, TP15.1, U8.1 (OUT)
~INV_FAULT: J4.2
~PWR_FAULT: J4.1
