sampidevkit/ACIM-Inverter/V0/Design/HW.ACIM-INV/VI_Measurement.kicad_sch

## KiCad design V0/Design/HW.ACIM-INV/VI_Measurement.kicad_sch (2024-09-25)

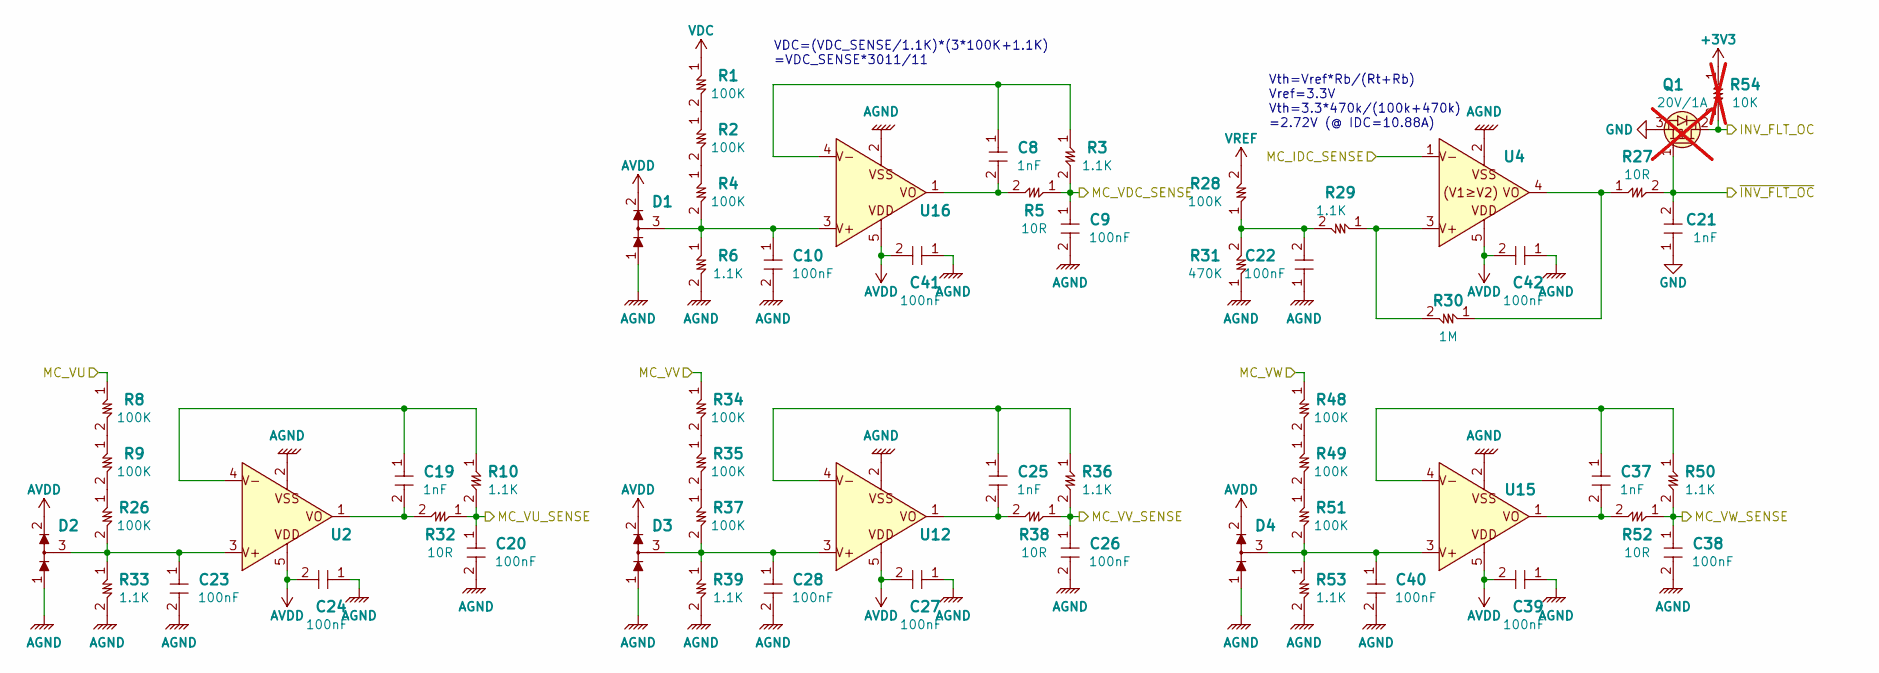
[picture p13: schematic VI_Measurement.kicad_sch]

Parts:
C8, C19, C21, C25, C37: 1nF; CAP0603
C9, C10, C20, C22, C23, C24, C26, C27, C28, C38, C39, C40, C41, C42: 100nF; CAP0603
D1, D2, D3, D4: GP DIODE; SOT23
Q1: 20V/1A; SOT23; not fitted
R1, R2, R4, R8, R9, R26, R28, R34, R35, R37, R48, R49, R51: 100K; RES0603
R3, R6, R10, R29, R33, R36, R39, R50, R53: 1.1K; RES0603
R5, R27, R32, R38, R52: 10R; RES0603
R30: 1M; RES1206
R31: 470K; RES0603
R54: 10K; RES0603; not fitted
U2, U12, U15, U16: OP-1CH; SOT353
U4: CMP-1CH; SOT25_DIODES

Connections:
+3V3: R54.1
AGND: C9.2, C10.2, C20.2, C22.1, C23.2, C24.1, C26.2, C27.1, C28.2, C38.2, C39.1, C40.2, C41.1, C42.1, D1.1 (K1), D2.1 (K1), D3.1 (K1), D4.1 (K1), R6.2, R31.1, R33.2, R39.2, R53.2, U2.2 (VSS), U4.2 (VSS), U12.2 (VSS), U15.2 (VSS), U16.2 (VSS)
AVDD: C24.2, C27.2, C39.2, C41.2, C42.2, D1.2 (K2), D2.2 (K2), D3.2 (K2), D4.2 (K2), U2.5 (VDD), U4.5 (VDD), U12.5 (VDD), U15.5 (VDD), U16.5 (VDD)
GND: C21.1, Q1.3 (S)
INV_FLT_OC: Q1.2 (D), R54.2
MC_IDC_SENSE: U4.1 (VIN-)
MC_VDC_SENSE: C9.1, R3.2, R5.1
MC_VU: R8.1
MC_VU_SENSE: C20.1, R10.2, R32.1
MC_VV: R34.1
MC_VV_SENSE: C26.1, R36.2, R38.1
MC_VW: R48.1
MC_VW_SENSE: C38.1, R50.2, R52.1
unnamed: C8.1, R3.1, U16.4 (VIN-)
unnamed: C8.2, R5.2, U16.1 (VOUT)
unnamed: C10.1, D1.3 (COM), R4.2, R6.1, U16.3 (VIN+)
unnamed: C19.1, R10.1, U2.4 (VIN-)
unnamed: C19.2, R32.2, U2.1 (VOUT)
unnamed: C22.2, R28.1, R29.2, R31.2
unnamed: C23.1, D2.3 (COM), R26.2, R33.1, U2.3 (VIN+)
unnamed: C25.1, R36.1, U12.4 (VIN-)
unnamed: C25.2, R38.2, U12.1 (VOUT)
unnamed: C28.1, D3.3 (COM), R37.2, R39.1, U12.3 (VIN+)
unnamed: C37.1, R50.1, U15.4 (VIN-)
unnamed: C37.2, R52.2, U15.1 (VOUT)
unnamed: C40.1, D4.3 (COM), R51.2, R53.1, U15.3 (VIN+)
unnamed: R1.2, R2.1
unnamed: R2.2, R4.1
unnamed: R8.2, R9.1
unnamed: R9.2, R26.1
unnamed: R27.1, R30.1, U4.4 (VOUT)
unnamed: R29.1, R30.2, U4.3 (VIN+)
unnamed: R34.2, R35.1
unnamed: R35.2, R37.1
unnamed: R48.2, R49.1
unnamed: R49.2, R51.1
VDC: R1.1
VREF: R28.2
~INV_FLT_OC: C21.2, Q1.1 (G), R27.2

Notes on the sheet:
Vth=Vref*Rb/(Rt+Rb) Vref=3.3V Vth=3.3*470k/(100k+470k) =2.72V (@ IDC=10.88A)
VDC=(VDC_SENSE/1.1K)*(3*100K+1.1K) =VDC_SENSE*3011/11
