sampidevkit/ACIM-Inverter/V0/Firmware/GPIO/src/config/default/peripheral/gpio/plib_gpio.h

/*******************************************************************************
  GPIO PLIB

  Company:
    Microchip Technology Inc.

  File Name:
    plib_gpio.h UUUUUUUUU

  Summary:
    GPIO PLIB Header File

  Description:
    This library provides an interface to control and interact with Parallel
    Input/Output controller (GPIO) module.

*******************************************************************************/

/*******************************************************************************
* Copyright (C) 2019 Microchip Technology Inc. and its subsidiaries.
*
* Subject to your compliance with these terms, you may use Microchip software
* and any derivatives exclusively with Microchip products. It is your
* responsibility to comply with third party license terms applicable to your
* use of third party software (including open source software) that may
* accompany Microchip software.
*
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
* IN NO EVENT WILL MICROCHIP BE LIABLE FOR ANY INDIRECT, SPECIAL, PUNITIVE,
* INCIDENTAL OR CONSEQUENTIAL LOSS, DAMAGE, COST OR EXPENSE OF ANY KIND
* WHATSOEVER RELATED TO THE SOFTWARE, HOWEVER CAUSED, EVEN IF MICROCHIP HAS
* BEEN ADVISED OF THE POSSIBILITY OR THE DAMAGES ARE FORESEEABLE. TO THE
* FULLEST EXTENT ALLOWED BY LAW, MICROCHIP'S TOTAL LIABILITY ON ALL CLAIMS IN
* ANY WAY RELATED TO THIS SOFTWARE WILL NOT EXCEED THE AMOUNT OF FEES, IF ANY,
* THAT YOU HAVE PAID DIRECTLY TO MICROCHIP FOR THIS SOFTWARE.
*******************************************************************************/

#ifndef PLIB_GPIO_H
#define PLIB_GPIO_H

#include <device.h>
#include <stdint.h>
#include <stdbool.h>
#include <stddef.h>

// DOM-IGNORE-BEGIN
#ifdef __cplusplus  // Provide C++ Compatibility

    extern "C" {

#endif
// DOM-IGNORE-END

// *****************************************************************************
// *****************************************************************************
// Section: Data types and constants
// *****************************************************************************
// *****************************************************************************


/*** Macros for IND_RUN pin ***/
#define IND_RUN_Set()               (LATASET = (1U<<7))
#define IND_RUN_Clear()             (LATACLR = (1U<<7))
#define IND_RUN_Toggle()            (LATAINV= (1U<<7))
#define IND_RUN_OutputEnable()      (TRISACLR = (1U<<7))
#define IND_RUN_InputEnable()       (TRISASET = (1U<<7))
#define IND_RUN_Get()               ((PORTA >> 7) & 0x1U)
#define IND_RUN_PIN                  GPIO_PIN_RA7

/*** Macros for ENC_A pin ***/
#define ENC_A_Get()               ((PORTG >> 6) & 0x1U)
#define ENC_A_PIN                  GPIO_PIN_RG6

/*** Macros for ENC_B pin ***/
#define ENC_B_Get()               ((PORTG >> 7) & 0x1U)
#define ENC_B_PIN                  GPIO_PIN_RG7

/*** Macros for ENC_INDEX pin ***/
#define ENC_INDEX_Get()               ((PORTG >> 8) & 0x1U)
#define ENC_INDEX_PIN                  GPIO_PIN_RG8

/*** Macros for ENC_HOME pin ***/
#define ENC_HOME_Get()               ((PORTG >> 9) & 0x1U)
#define ENC_HOME_PIN                  GPIO_PIN_RG9

/*** Macros for MC_VDC_SENSE pin ***/
#define MC_VDC_SENSE_Get()               ((PORTA >> 12) & 0x1U)
#define MC_VDC_SENSE_PIN                  GPIO_PIN_RA12

/*** Macros for MC_IDC_SENSE pin ***/
#define MC_IDC_SENSE_Get()               ((PORTA >> 11) & 0x1U)
#define MC_IDC_SENSE_PIN                  GPIO_PIN_RA11

/*** Macros for MC_IU_SENSE pin ***/
#define MC_IU_SENSE_Get()               ((PORTA >> 0) & 0x1U)
#define MC_IU_SENSE_PIN                  GPIO_PIN_RA0

/*** Macros for MC_IV_SENSE pin ***/
#define MC_IV_SENSE_Get()               ((PORTA >> 1) & 0x1U)
#define MC_IV_SENSE_PIN                  GPIO_PIN_RA1

/*** Macros for MC_IW_SENSE pin ***/
#define MC_IW_SENSE_Get()               ((PORTB >> 0) & 0x1U)
#define MC_IW_SENSE_PIN                  GPIO_PIN_RB0

/*** Macros for MC_VU_SENSE pin ***/
#define MC_VU_SENSE_Get()               ((PORTB >> 1) & 0x1U)
#define MC_VU_SENSE_PIN                  GPIO_PIN_RB1

/*** Macros for MC_VW_SENSE pin ***/
#define MC_VW_SENSE_Get()               ((PORTC >> 0) & 0x1U)
#define MC_VW_SENSE_PIN                  GPIO_PIN_RC0

/*** Macros for MC_VV_SENSE pin ***/
#define MC_VV_SENSE_Get()               ((PORTC >> 1) & 0x1U)
#define MC_VV_SENSE_PIN                  GPIO_PIN_RC1

/*** Macros for MC_IPM_TEMP pin ***/
#define MC_IPM_TEMP_Get()               ((PORTC >> 2) & 0x1U)
#define MC_IPM_TEMP_PIN                  GPIO_PIN_RC2

/*** Macros for SYS_CLK pin ***/
#define SYS_CLK_Get()               ((PORTC >> 12) & 0x1U)
#define SYS_CLK_PIN                  GPIO_PIN_RC12

/*** Macros for SYS_CLK_EN pin ***/
#define SYS_CLK_EN_Set()               (LATCSET = (1U<<15))
#define SYS_CLK_EN_Clear()             (LATCCLR = (1U<<15))
#define SYS_CLK_EN_Toggle()            (LATCINV= (1U<<15))
#define SYS_CLK_EN_OutputEnable()      (TRISCCLR = (1U<<15))
#define SYS_CLK_EN_InputEnable()       (TRISCSET = (1U<<15))
#define SYS_CLK_EN_Get()               ((PORTC >> 15) & 0x1U)
#define SYS_CLK_EN_PIN                  GPIO_PIN_RC15

/*** Macros for RXD2 pin ***/
#define RXD2_Get()               ((PORTB >> 5) & 0x1U)
#define RXD2_PIN                  GPIO_PIN_RB5

/*** Macros for RXD1 pin ***/
#define RXD1_Get()               ((PORTB >> 6) & 0x1U)
#define RXD1_PIN                  GPIO_PIN_RB6

/*** Macros for TXD2 pin ***/
#define TXD2_Get()               ((PORTC >> 10) & 0x1U)
#define TXD2_PIN                  GPIO_PIN_RC10

/*** Macros for TXD1 pin ***/
#define TXD1_Get()               ((PORTB >> 7) & 0x1U)
#define TXD1_PIN                  GPIO_PIN_RB7

/*** Macros for MC_PWM_WH pin ***/
#define MC_PWM_WH_Set()               (LATCSET = (1U<<6))
#define MC_PWM_WH_Clear()             (LATCCLR = (1U<<6))
#define MC_PWM_WH_Toggle()            (LATCINV= (1U<<6))
#define MC_PWM_WH_OutputEnable()      (TRISCCLR = (1U<<6))
#define MC_PWM_WH_InputEnable()       (TRISCSET = (1U<<6))
#define MC_PWM_WH_Get()               ((PORTC >> 6) & 0x1U)
#define MC_PWM_WH_PIN                  GPIO_PIN_RC6

/*** Macros for MC_PWM_WL pin ***/
#define MC_PWM_WL_Set()               (LATCSET = (1U<<7))
#define MC_PWM_WL_Clear()             (LATCCLR = (1U<<7))
#define MC_PWM_WL_Toggle()            (LATCINV= (1U<<7))
#define MC_PWM_WL_OutputEnable()      (TRISCCLR = (1U<<7))
#define MC_PWM_WL_InputEnable()       (TRISCSET = (1U<<7))
#define MC_PWM_WL_Get()               ((PORTC >> 7) & 0x1U)
#define MC_PWM_WL_PIN                  GPIO_PIN_RC7

/*** Macros for MC_PWM_VH pin ***/
#define MC_PWM_VH_Set()               (LATCSET = (1U<<8))
#define MC_PWM_VH_Clear()             (LATCCLR = (1U<<8))
#define MC_PWM_VH_Toggle()            (LATCINV= (1U<<8))
#define MC_PWM_VH_OutputEnable()      (TRISCCLR = (1U<<8))
#define MC_PWM_VH_InputEnable()       (TRISCSET = (1U<<8))
#define MC_PWM_VH_Get()               ((PORTC >> 8) & 0x1U)
#define MC_PWM_VH_PIN                  GPIO_PIN_RC8

/*** Macros for MC_PWM_UH pin ***/
#define MC_PWM_UH_Set()               (LATDSET = (1U<<5))
#define MC_PWM_UH_Clear()             (LATDCLR = (1U<<5))
#define MC_PWM_UH_Toggle()            (LATDINV= (1U<<5))
#define MC_PWM_UH_OutputEnable()      (TRISDCLR = (1U<<5))
#define MC_PWM_UH_InputEnable()       (TRISDSET = (1U<<5))
#define MC_PWM_UH_Get()               ((PORTD >> 5) & 0x1U)
#define MC_PWM_UH_PIN                  GPIO_PIN_RD5

/*** Macros for MC_PWM_UL pin ***/
#define MC_PWM_UL_Set()               (LATDSET = (1U<<6))
#define MC_PWM_UL_Clear()             (LATDCLR = (1U<<6))
#define MC_PWM_UL_Toggle()            (LATDINV= (1U<<6))
#define MC_PWM_UL_OutputEnable()      (TRISDCLR = (1U<<6))
#define MC_PWM_UL_InputEnable()       (TRISDSET = (1U<<6))
#define MC_PWM_UL_Get()               ((PORTD >> 6) & 0x1U)
#define MC_PWM_UL_PIN                  GPIO_PIN_RD6

/*** Macros for MC_PWM_VL pin ***/
#define MC_PWM_VL_Set()               (LATCSET = (1U<<9))
#define MC_PWM_VL_Clear()             (LATCCLR = (1U<<9))
#define MC_PWM_VL_Toggle()            (LATCINV= (1U<<9))
#define MC_PWM_VL_OutputEnable()      (TRISCCLR = (1U<<9))
#define MC_PWM_VL_InputEnable()       (TRISCSET = (1U<<9))
#define MC_PWM_VL_Get()               ((PORTC >> 9) & 0x1U)
#define MC_PWM_VL_PIN                  GPIO_PIN_RC9

/*** Macros for INV_FLT_OC pin ***/
#define INV_FLT_OC_Set()               (LATFSET = (1U<<1))
#define INV_FLT_OC_Clear()             (LATFCLR = (1U<<1))
#define INV_FLT_OC_Toggle()            (LATFINV= (1U<<1))
#define INV_FLT_OC_OutputEnable()      (TRISFCLR = (1U<<1))
#define INV_FLT_OC_InputEnable()       (TRISFSET = (1U<<1))
#define INV_FLT_OC_Get()               ((PORTF >> 1) & 0x1U)
#define INV_FLT_OC_PIN                  GPIO_PIN_RF1
#define INV_FLT_OC_InterruptEnable()   (CNENFSET = (1U<<1))
#define INV_FLT_OC_InterruptDisable()  (CNENFCLR = (1U<<1))

/*** Macros for CUR_LIM_DIS pin ***/
#define CUR_LIM_DIS_Set()               (LATBSET = (1U<<12))
#define CUR_LIM_DIS_Clear()             (LATBCLR = (1U<<12))
#define CUR_LIM_DIS_Toggle()            (LATBINV= (1U<<12))
#define CUR_LIM_DIS_OutputEnable()      (TRISBCLR = (1U<<12))
#define CUR_LIM_DIS_InputEnable()       (TRISBSET = (1U<<12))
#define CUR_LIM_DIS_Get()               ((PORTB >> 12) & 0x1U)
#define CUR_LIM_DIS_PIN                  GPIO_PIN_RB12

/*** Macros for VDC_EN pin ***/
#define VDC_EN_Set()               (LATBSET = (1U<<13))
#define VDC_EN_Clear()             (LATBCLR = (1U<<13))
#define VDC_EN_Toggle()            (LATBINV= (1U<<13))
#define VDC_EN_OutputEnable()      (TRISBCLR = (1U<<13))
#define VDC_EN_InputEnable()       (TRISBSET = (1U<<13))
#define VDC_EN_Get()               ((PORTB >> 13) & 0x1U)
#define VDC_EN_PIN                  GPIO_PIN_RB13

/*** Macros for IND_ERR_N pin ***/
#define IND_ERR_N_Set()               (LATASET = (1U<<10))
#define IND_ERR_N_Clear()             (LATACLR = (1U<<10))
#define IND_ERR_N_Toggle()            (LATAINV= (1U<<10))
#define IND_ERR_N_OutputEnable()      (TRISACLR = (1U<<10))
#define IND_ERR_N_InputEnable()       (TRISASET = (1U<<10))
#define IND_ERR_N_Get()               ((PORTA >> 10) & 0x1U)
#define IND_ERR_N_PIN                  GPIO_PIN_RA10


// *****************************************************************************
/* GPIO Port

  Summary:
    Identifies the available GPIO Ports.

  Description:
    This enumeration identifies the available GPIO Ports.

  Remarks:
    The caller should not rely on the specific numbers assigned to any of
    these values as they may change from one processor to the next.

    Not all ports are available on all devices.  Refer to the specific
    device data sheet to determine which ports are supported.
*/


#define    GPIO_PORT_A  (0)
#define    GPIO_PORT_B  (1)
#define    GPIO_PORT_C  (2)
#define    GPIO_PORT_D  (3)
#define    GPIO_PORT_E  (4)
#define    GPIO_PORT_F  (5)
#define    GPIO_PORT_G  (6)
typedef uint32_t GPIO_PORT;

typedef enum
{
    GPIO_INTERRUPT_ON_MISMATCH,
    GPIO_INTERRUPT_ON_RISING_EDGE,
    GPIO_INTERRUPT_ON_FALLING_EDGE,
    GPIO_INTERRUPT_ON_BOTH_EDGES,
}GPIO_INTERRUPT_STYLE;

// *****************************************************************************
/* GPIO Port Pins

  Summary:
    Identifies the available GPIO port pins.

  Description:
    This enumeration identifies the available GPIO port pins.

  Remarks:
    The caller should not rely on the specific numbers assigned to any of
    these values as they may change from one processor to the next.

    Not all pins are available on all devices.  Refer to the specific
    device data sheet to determine which pins are supported.
*/


#define     GPIO_PIN_RA0  (0U)
#define     GPIO_PIN_RA1  (1U)
#define     GPIO_PIN_RA4  (4U)
#define     GPIO_PIN_RA7  (7U)
#define     GPIO_PIN_RA8  (8U)
#define     GPIO_PIN_RA10  (10U)
#define     GPIO_PIN_RA11  (11U)
#define     GPIO_PIN_RA12  (12U)
#define     GPIO_PIN_RB0  (16U)
#define     GPIO_PIN_RB1  (17U)
#define     GPIO_PIN_RB2  (18U)
#define     GPIO_PIN_RB3  (19U)
#define     GPIO_PIN_RB4  (20U)
#define     GPIO_PIN_RB5  (21U)
#define     GPIO_PIN_RB6  (22U)
#define     GPIO_PIN_RB7  (23U)
#define     GPIO_PIN_RB8  (24U)
#define     GPIO_PIN_RB9  (25U)
#define     GPIO_PIN_RB10  (26U)
#define     GPIO_PIN_RB11  (27U)
#define     GPIO_PIN_RB12  (28U)
#define     GPIO_PIN_RB13  (29U)
#define     GPIO_PIN_RB14  (30U)
#define     GPIO_PIN_RB15  (31U)
#define     GPIO_PIN_RC0  (32U)
#define     GPIO_PIN_RC1  (33U)
#define     GPIO_PIN_RC2  (34U)
#define     GPIO_PIN_RC6  (38U)
#define     GPIO_PIN_RC7  (39U)
#define     GPIO_PIN_RC8  (40U)
#define     GPIO_PIN_RC9  (41U)
#define     GPIO_PIN_RC10  (42U)
#define     GPIO_PIN_RC11  (43U)
#define     GPIO_PIN_RC12  (44U)
#define     GPIO_PIN_RC13  (45U)
#define     GPIO_PIN_RC15  (47U)
#define     GPIO_PIN_RD5  (53U)
#define     GPIO_PIN_RD6  (54U)
#define     GPIO_PIN_RD8  (56U)
#define     GPIO_PIN_RE12  (76U)
#define     GPIO_PIN_RE13  (77U)
#define     GPIO_PIN_RE14  (78U)
#define     GPIO_PIN_RE15  (79U)
#define     GPIO_PIN_RF0  (80U)
#define     GPIO_PIN_RF1  (81U)
#define     GPIO_PIN_RG6  (102U)
#define     GPIO_PIN_RG7  (103U)
#define     GPIO_PIN_RG8  (104U)
#define     GPIO_PIN_RG9  (105U)

    /* This element should not be used in any of the GPIO APIs.
       It will be used by other modules or application to denote that none of the GPIO Pin is used */
#define    GPIO_PIN_NONE   (-1)

typedef uint32_t GPIO_PIN;

typedef  void (*GPIO_PIN_CALLBACK) ( GPIO_PIN pin, uintptr_t context);

void GPIO_Initialize(void);

// *****************************************************************************
// *****************************************************************************
// Section: GPIO Functions which operates on multiple pins of a port
// *****************************************************************************
// *****************************************************************************

uint32_t GPIO_PortRead(GPIO_PORT port);

void GPIO_PortWrite(GPIO_PORT port, uint32_t mask, uint32_t value);

uint32_t GPIO_PortLatchRead ( GPIO_PORT port );

void GPIO_PortSet(GPIO_PORT port, uint32_t mask);

void GPIO_PortClear(GPIO_PORT port, uint32_t mask);

void GPIO_PortToggle(GPIO_PORT port, uint32_t mask);

void GPIO_PortInputEnable(GPIO_PORT port, uint32_t mask);

void GPIO_PortOutputEnable(GPIO_PORT port, uint32_t mask);

void GPIO_PortInterruptEnable(GPIO_PORT port, uint32_t mask);

void GPIO_PortInterruptDisable(GPIO_PORT port, uint32_t mask);

// *****************************************************************************
// *****************************************************************************
// Section: Local Data types and Prototypes
// *****************************************************************************
// *****************************************************************************

typedef struct {

    /* target pin */
    GPIO_PIN                 pin;

    /* Callback for event on target pin*/
    GPIO_PIN_CALLBACK        callback;

    /* Callback Context */
    uintptr_t               context;

} GPIO_PIN_CALLBACK_OBJ;

// *****************************************************************************
// *****************************************************************************
// Section: GPIO Functions which operates on one pin at a time
// *****************************************************************************
// *****************************************************************************

static inline void GPIO_PinWrite(GPIO_PIN pin, bool value)
{
	 uint32_t xvalue = (uint32_t)value;
    GPIO_PortWrite((pin>>4U), (uint32_t)(0x1U) << (pin & 0xFU), (xvalue) << (pin & 0xFU));
}

static inline bool GPIO_PinRead(GPIO_PIN pin)
{
    return ((((GPIO_PortRead((GPIO_PORT)(pin>>4U))) >> (pin & 0xFU)) & 0x1U) != 0U);
}

static inline bool GPIO_PinLatchRead(GPIO_PIN pin)
{
    return (((GPIO_PortLatchRead((GPIO_PORT)(pin>>4U)) >> (pin & 0xFU)) & 0x1U) != 0U);
}

static inline void GPIO_PinToggle(GPIO_PIN pin)
{
    GPIO_PortToggle((pin>>4U), (uint32_t)0x1U << (pin & 0xFU));
}

static inline void GPIO_PinSet(GPIO_PIN pin)
{
    GPIO_PortSet((pin>>4U), (uint32_t)0x1U << (pin & 0xFU));
}

static inline void GPIO_PinClear(GPIO_PIN pin)
{
    GPIO_PortClear((pin>>4U), (uint32_t)0x1U << (pin & 0xFU));
}

static inline void GPIO_PinInputEnable(GPIO_PIN pin)
{
    GPIO_PortInputEnable((pin>>4U), (uint32_t)0x1U << (pin & 0xFU));
}

static inline void GPIO_PinOutputEnable(GPIO_PIN pin)
{
    GPIO_PortOutputEnable((pin>>4U), (uint32_t)0x1U << (pin & 0xFU));
}

#define GPIO_PinInterruptEnable(pin)       GPIO_PinIntEnable(pin, GPIO_INTERRUPT_ON_MISMATCH)
#define GPIO_PinInterruptDisable(pin)      GPIO_PinIntDisable(pin)

void GPIO_PinIntEnable(GPIO_PIN pin, GPIO_INTERRUPT_STYLE style);
void GPIO_PinIntDisable(GPIO_PIN pin);

bool GPIO_PinInterruptCallbackRegister(
    GPIO_PIN pin,
    const   GPIO_PIN_CALLBACK callback,
    uintptr_t context
);

// DOM-IGNORE-BEGIN
#ifdef __cplusplus  // Provide C++ Compatibility

    }

#endif
// DOM-IGNORE-END
#endif // PLIB_GPIO_H
