sampidevkit/ACIM-Inverter/(commit log)

2024-09-25 V0 production files
    [HW.ACIM-INV-B_Cu.gbr, HW.ACIM-INV-B_Mask.gbr, HW.ACIM-INV-B_Paste.gbr, HW.ACIM-INV-B_Silkscreen.gbr, HW.ACIM-INV-Edge_Cuts.gbr, HW.ACIM-INV-F_Cu.gbr, HW.ACIM-INV-F_Mask.gbr, HW.ACIM-INV-F_Paste.gbr]
2024-10-11 HW.ACIM-INV_REV0.0 firmware configuration
    [MCU.kicad_sch, configuration.h]
2024-10-12 Add FwLib sub-module
    [configuration.h]
2024-10-16 Add 3P PWM, PwrMoni
2024-10-17 Update PwrMoni, add Encoder lib
